Wim426F/HVCU-Hardware/(threads)

Thread 6 (2024-01-12):

fix CAN-bus IC part number. (must be 3.3v supply version)

Wim426F, 2024-01-12:

Wim426F, 2024-10-08:
Used SN65 for 3.3V and TJA1050 for 5V

Closed 2024-10-08.

Thread 7 (2024-01-12):

change 12v output to mosfets instead of transistors

Wim426F, 2024-01-12:
saves a few parts

Wim426F, 2024-10-08:
Kept transistors because they are used elsewhere already.
Did check the schematic again and had to flip 2 resistors in a divider network to prevent
transistor base overvoltage.

Closed 2024-10-08.

Thread 10 (2024-08-16):

Add chargeport temp sensor input

Wim426F, 2024-08-16:

Wim426F, 2024-10-09:
Added 1 chargeport temperature sensor input.
Circuit copied from tested superman controller schematic.

Closed 2024-10-09.

Thread 11 (2024-08-16):

Merge 2 connectors

Wim426F, 2024-08-16:
Merge 2 connectors for vehicle and i3 LIM

Wim426F, 2024-10-09:
Merged vehicle and i3 lim connector into 1 10-pin connector for easier wiring.

Closed 2024-10-09.
