Wim426F/HVCU-Hardware/hv_controller.pdf

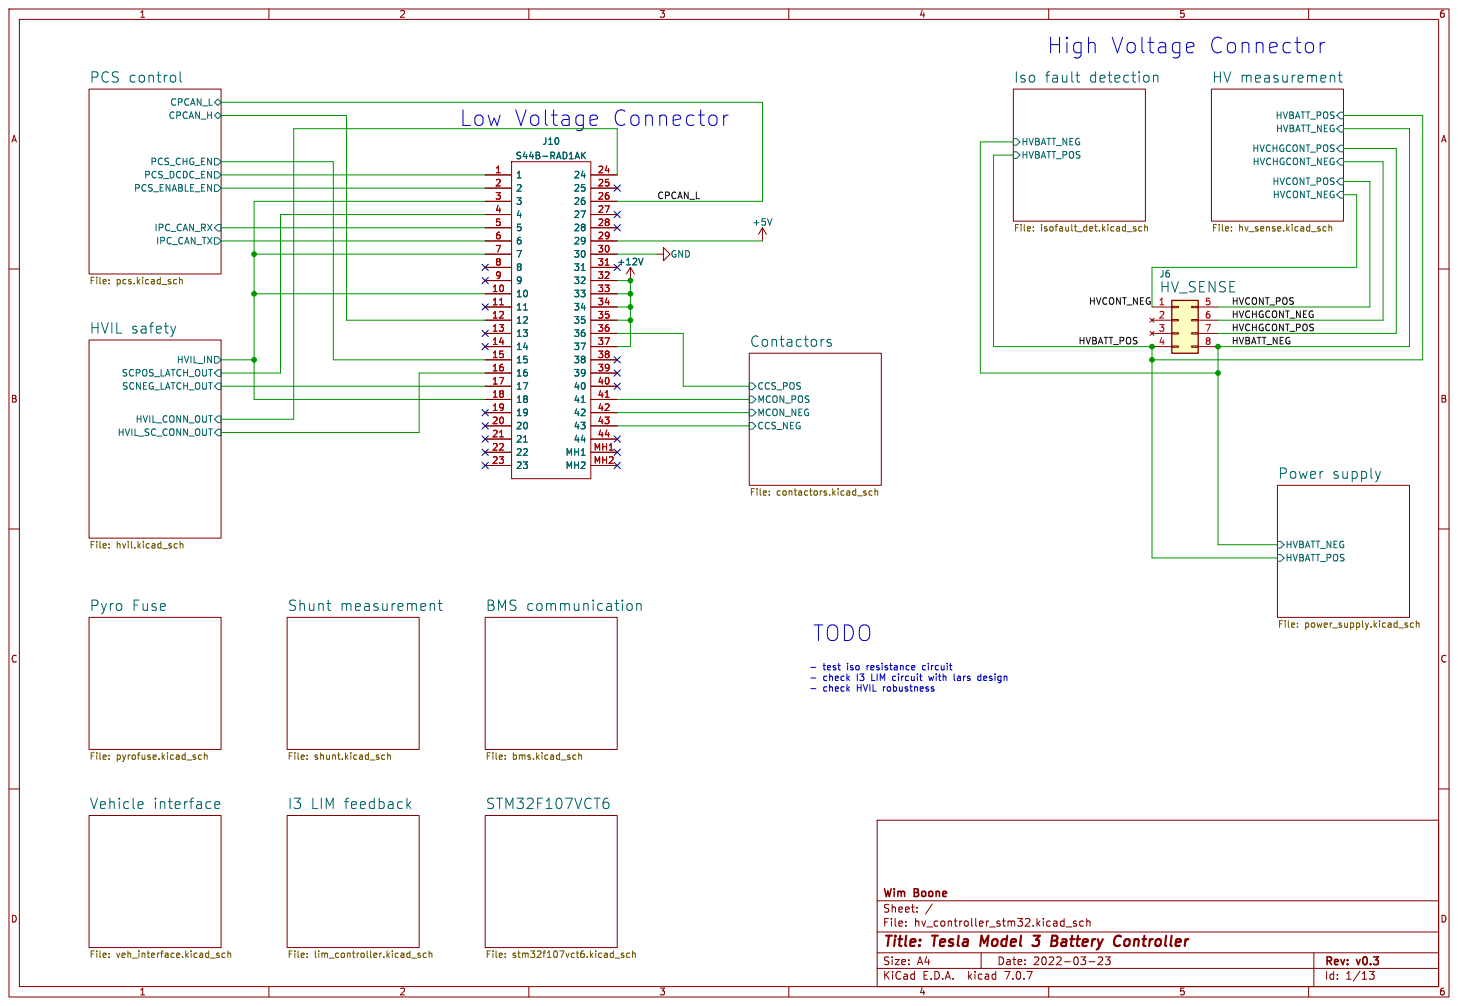
[picture p1: page 1]

HVCHGCONT_POS HV measurement File: hv_sense.kicad_sch Vehicle interface

File: contactors.kicad_sch BMS communication

File: hvil.kicad_sch Pyro Fuse

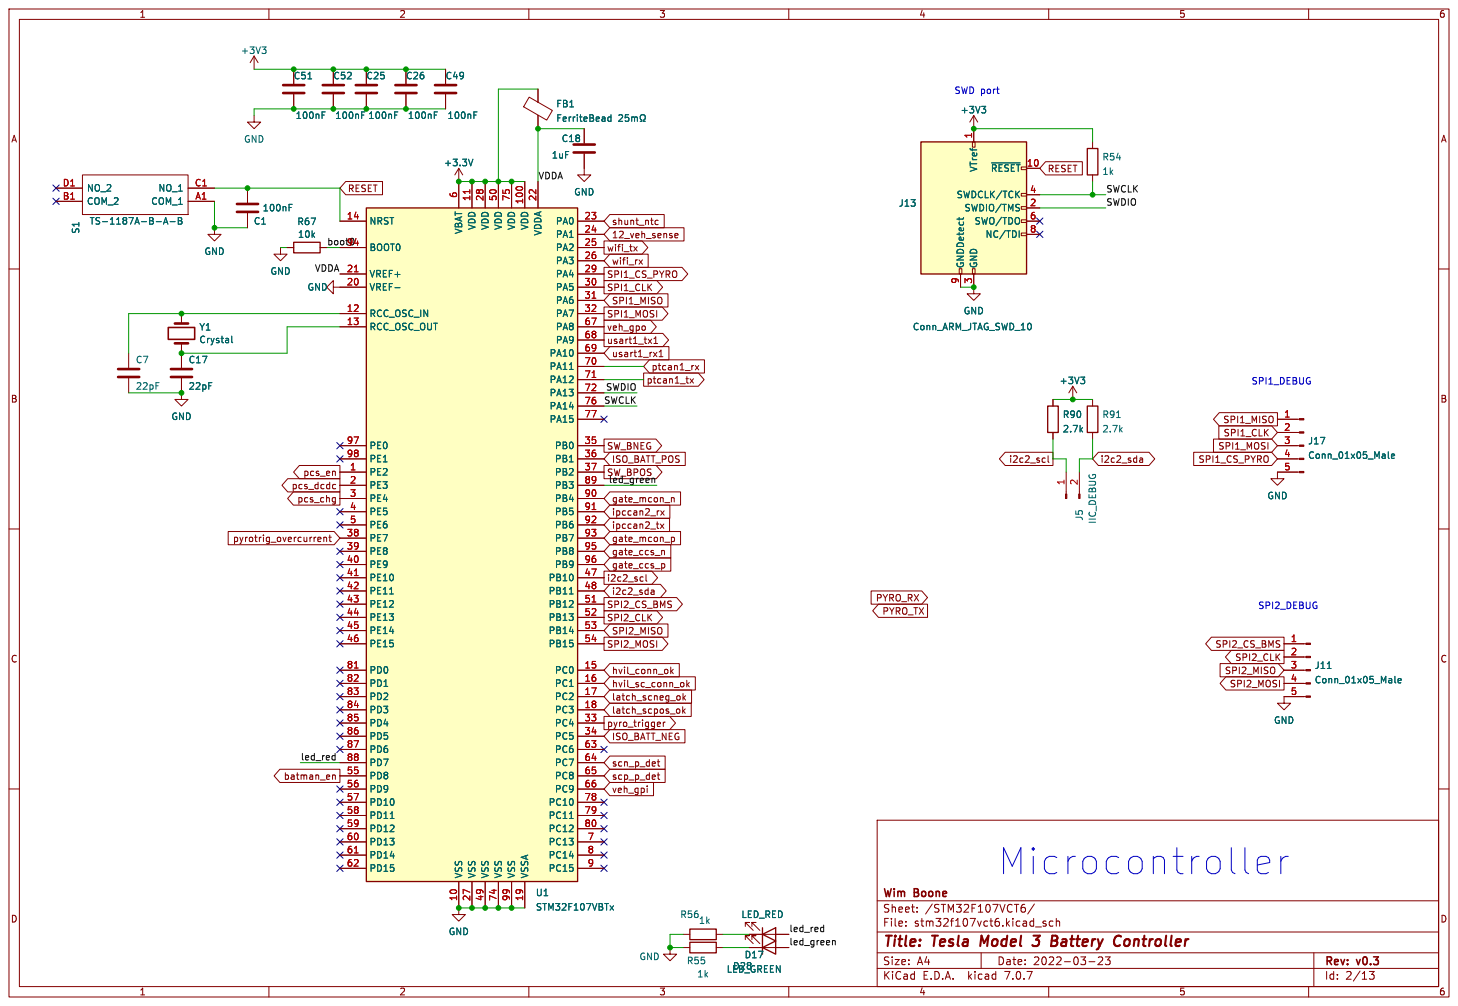
[picture p2: page 2]

3 SWDCLK/TCK 4 SWO/TDO 6 NC/TDI 8 GNDDetect 9

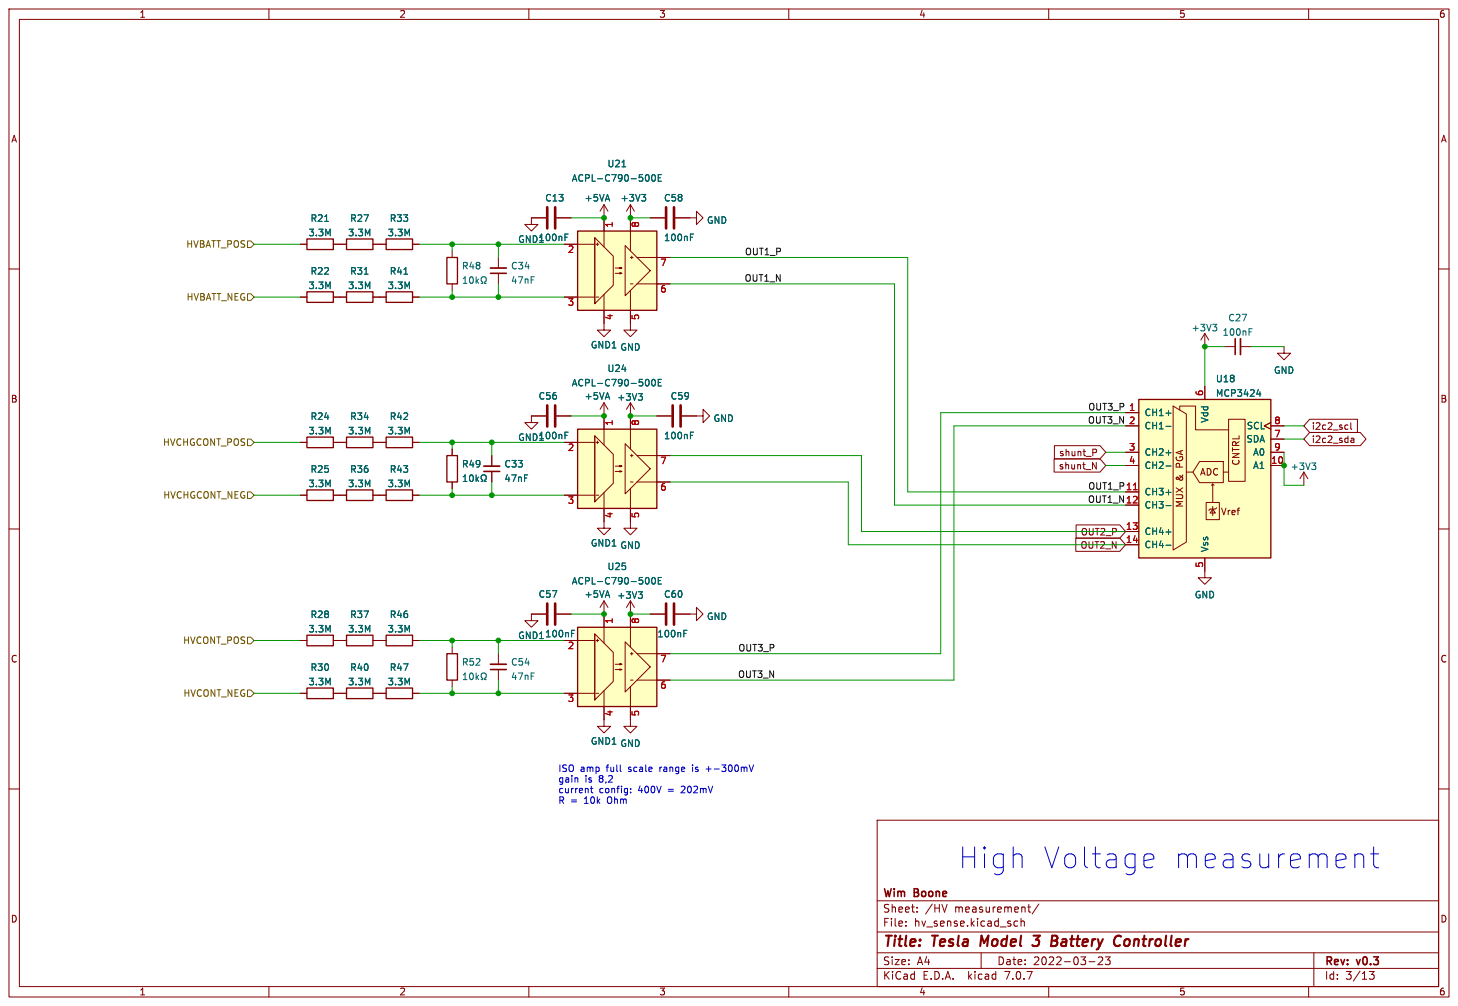
[picture p3: page 3]

ISO amp full scale range is +-300mV
gain is 8,2

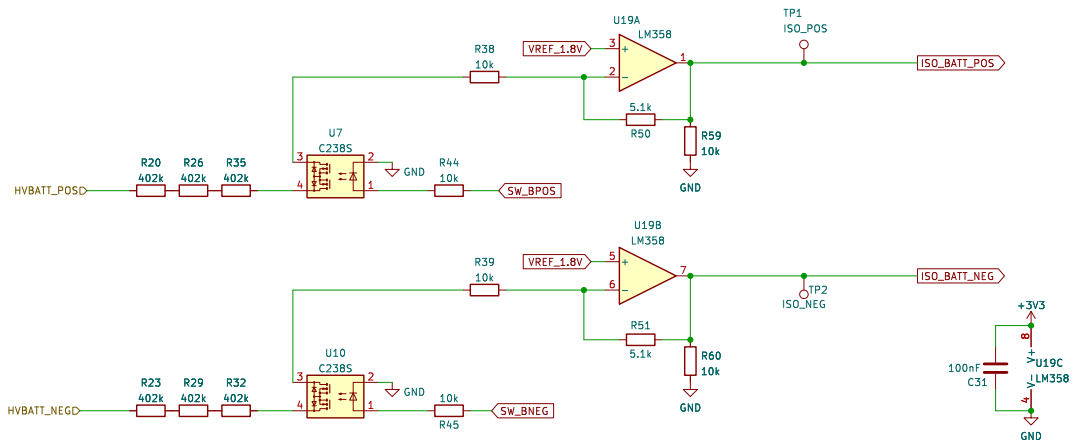
[picture p4: page 4]

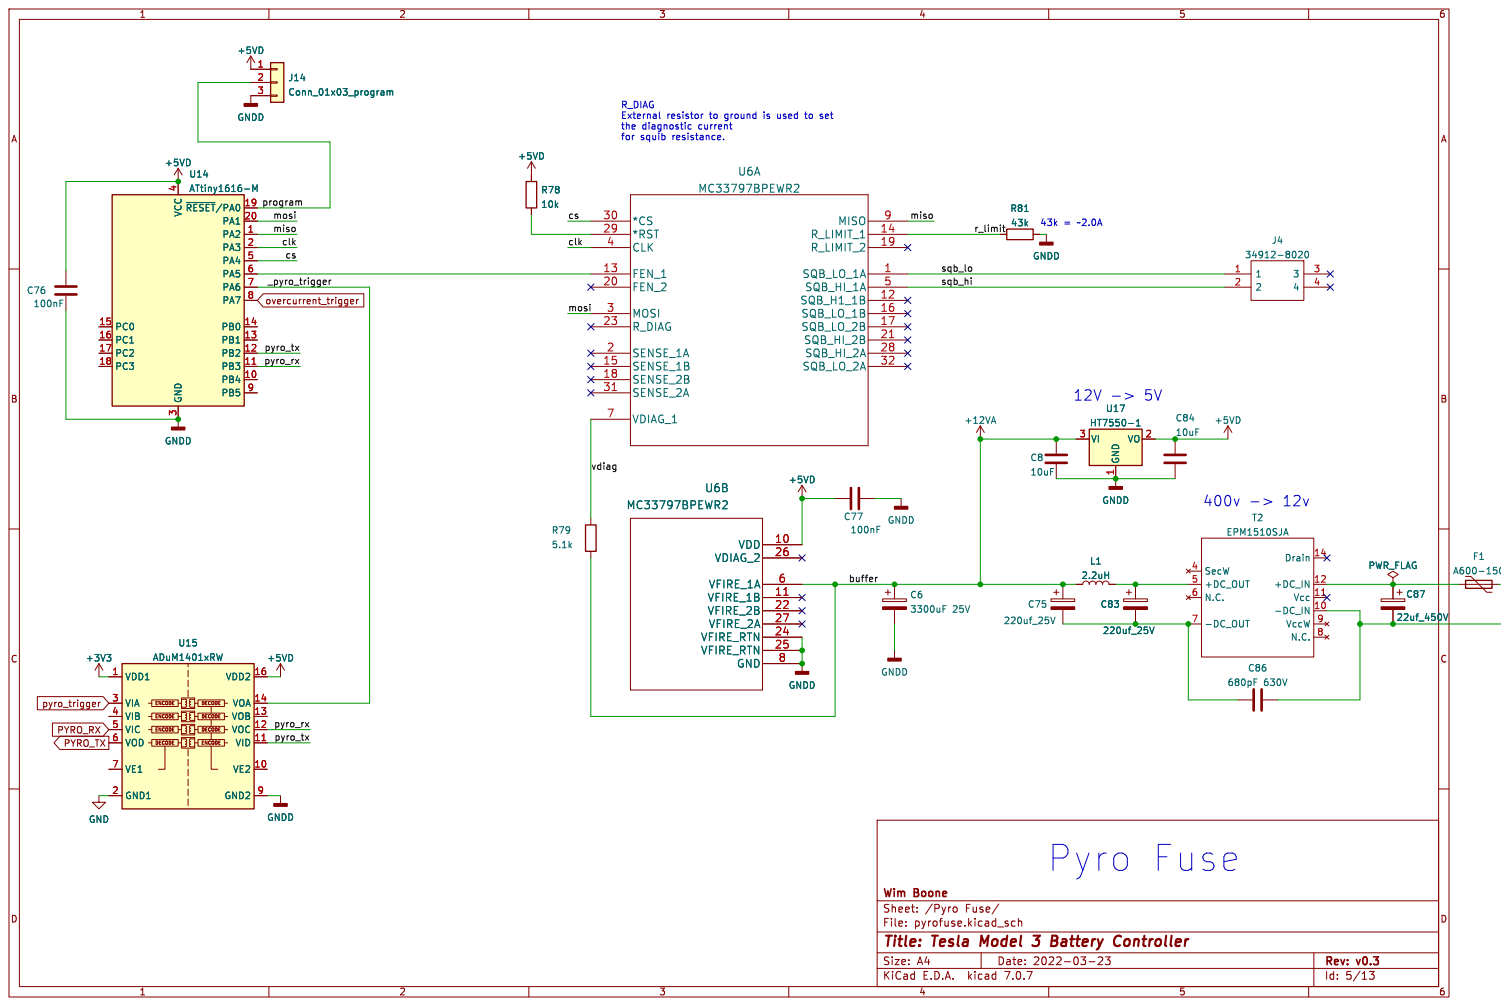
[picture p5: page 5]

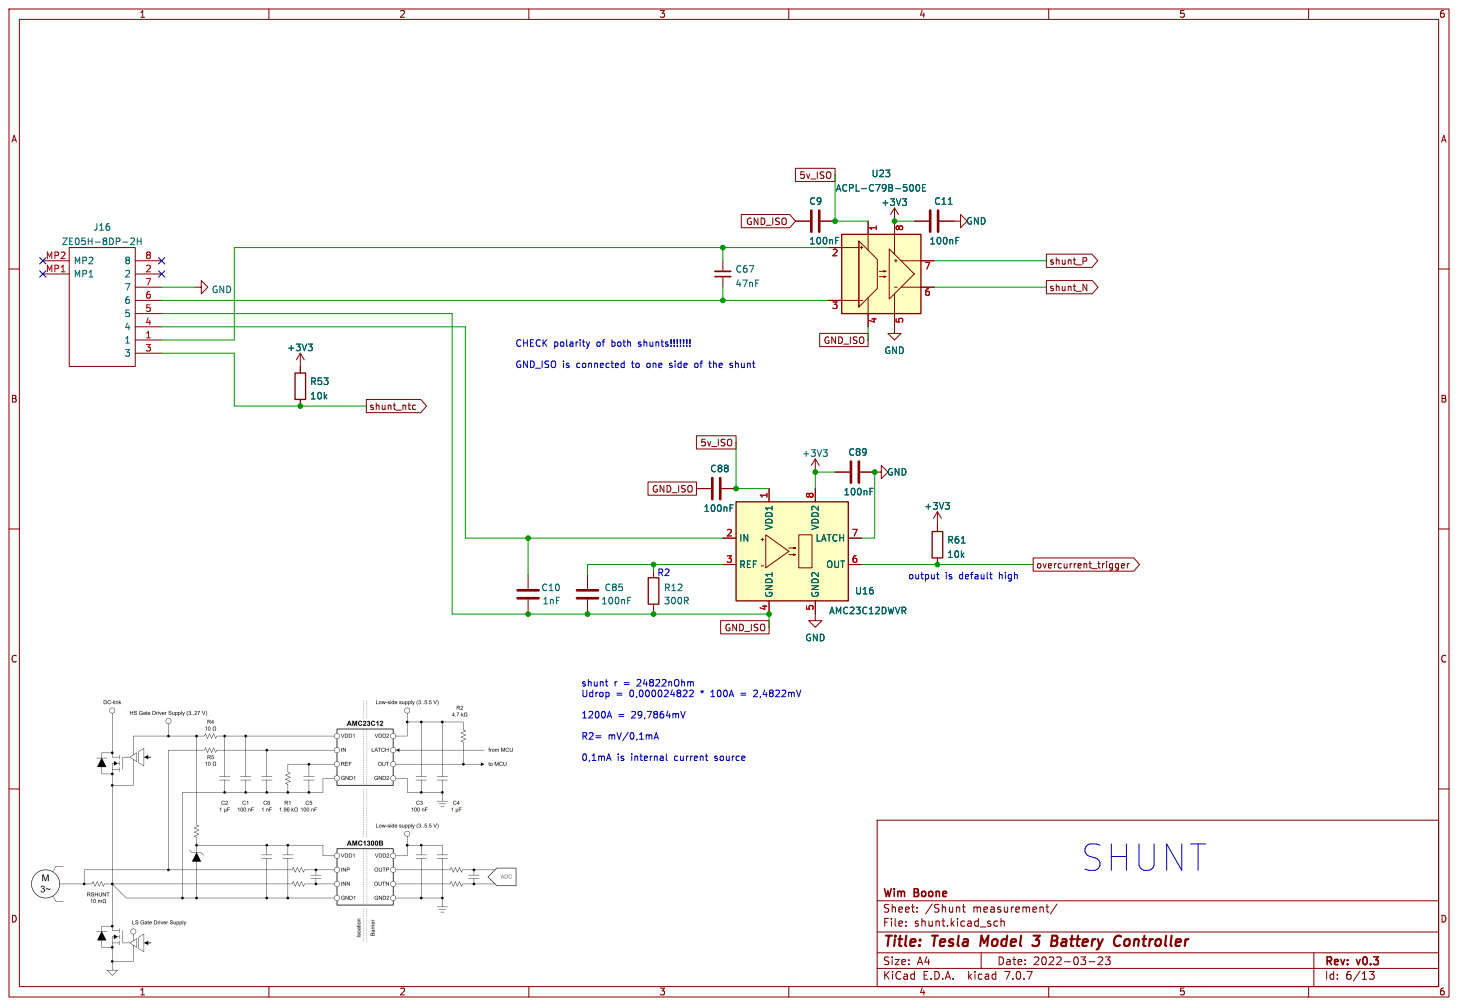
[picture p6: page 6]

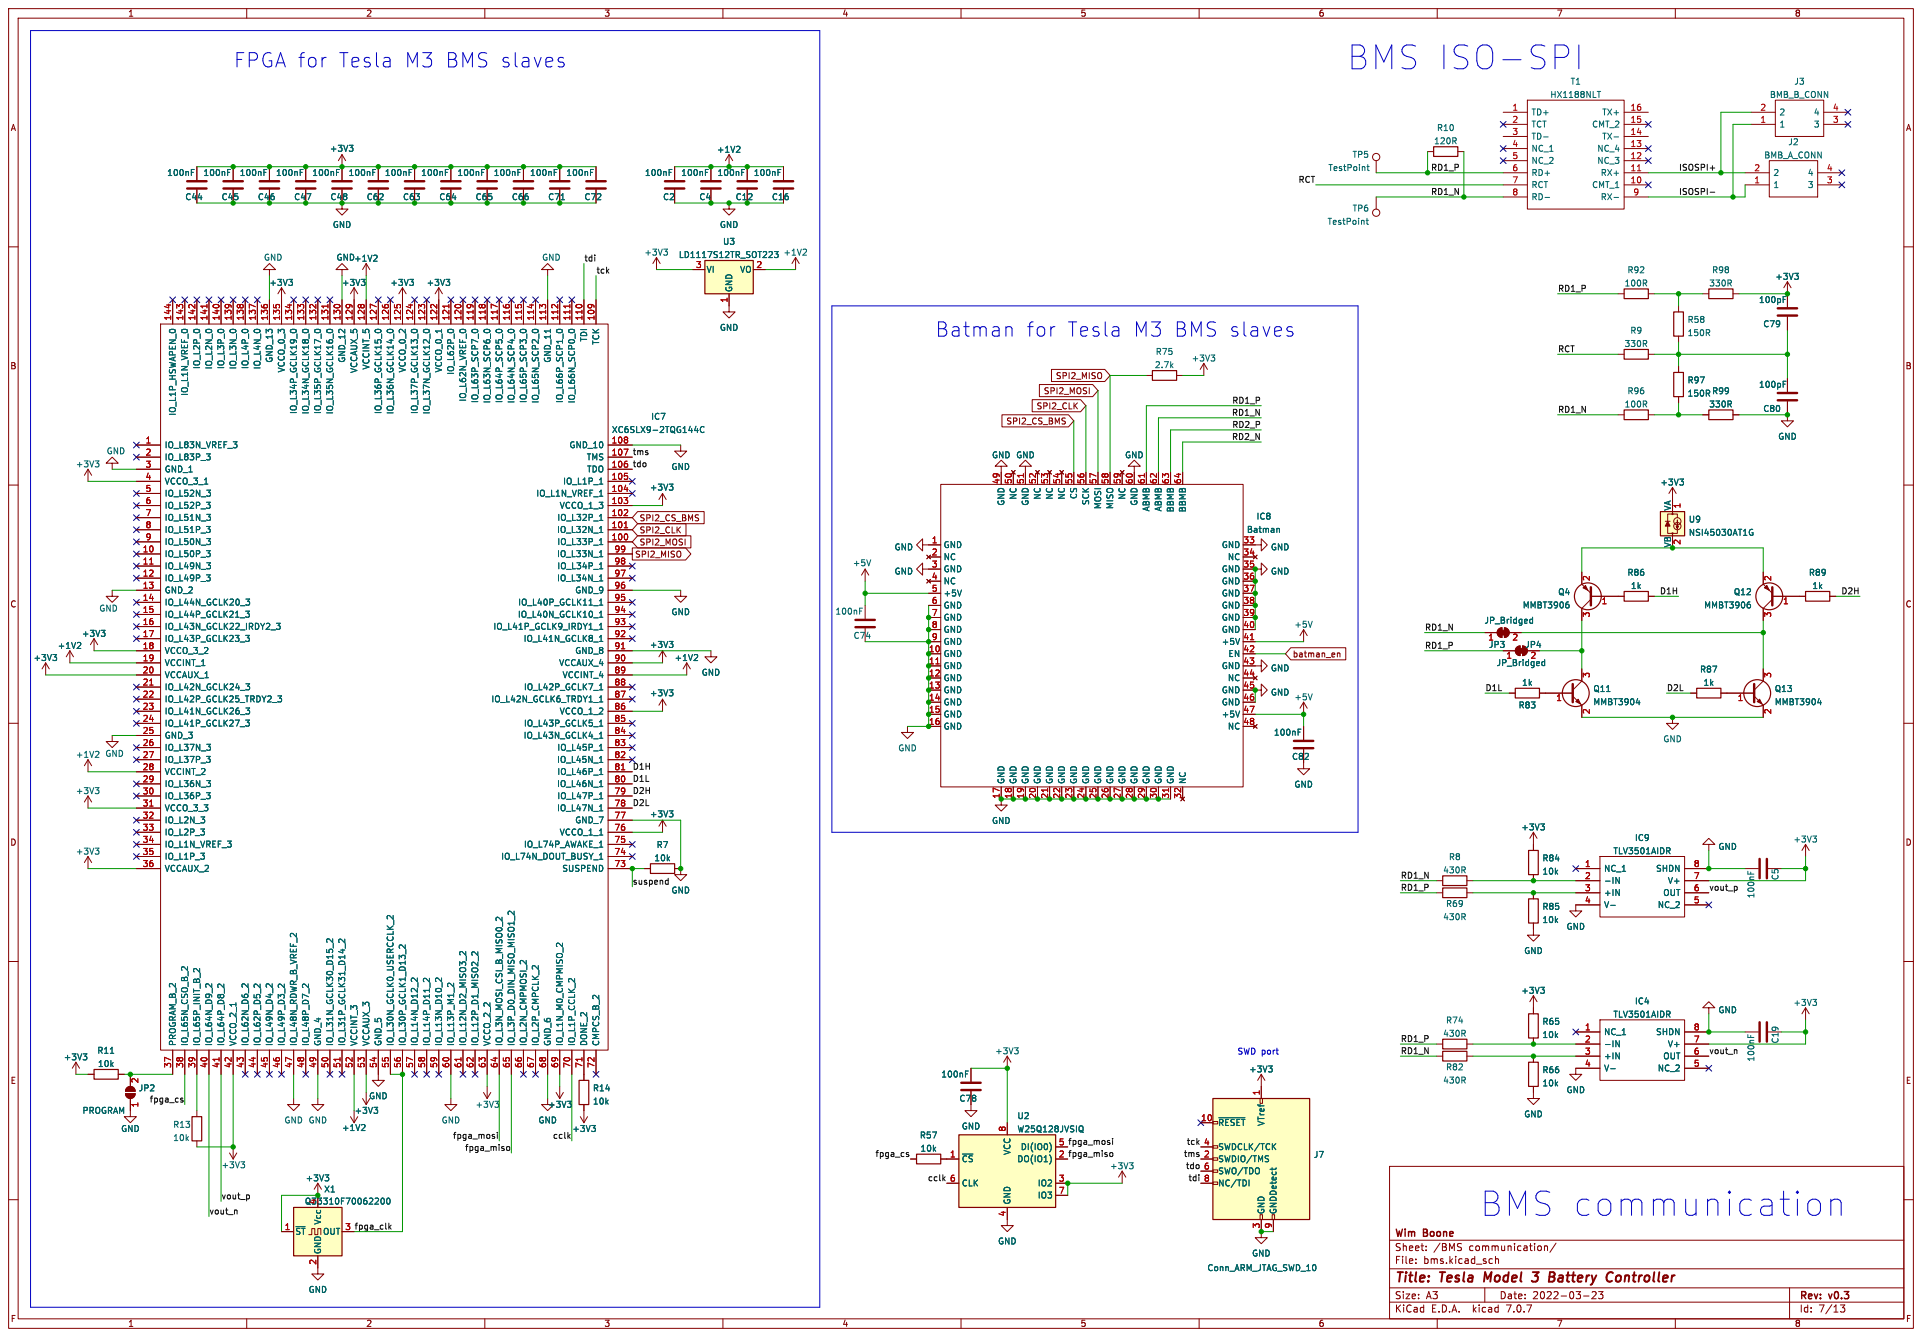
[picture p7: page 7]

Batman for Tesla M3 BMS slaves

8 GND GND GND GND

3 SWDCLK/TCK 4 SWO/TDO 6 NC/TDI 8 GNDDetect 9 +3V3 U2 W25Q128JVSIQ

2 OUT 3 Vcc 4 X1 Q33310F70062200 ~{CS} 1 DO(IO1) 2

3 SWDCLK/TCK 4 SWO/TDO 6 NC/TDI 8 GNDDetect 9

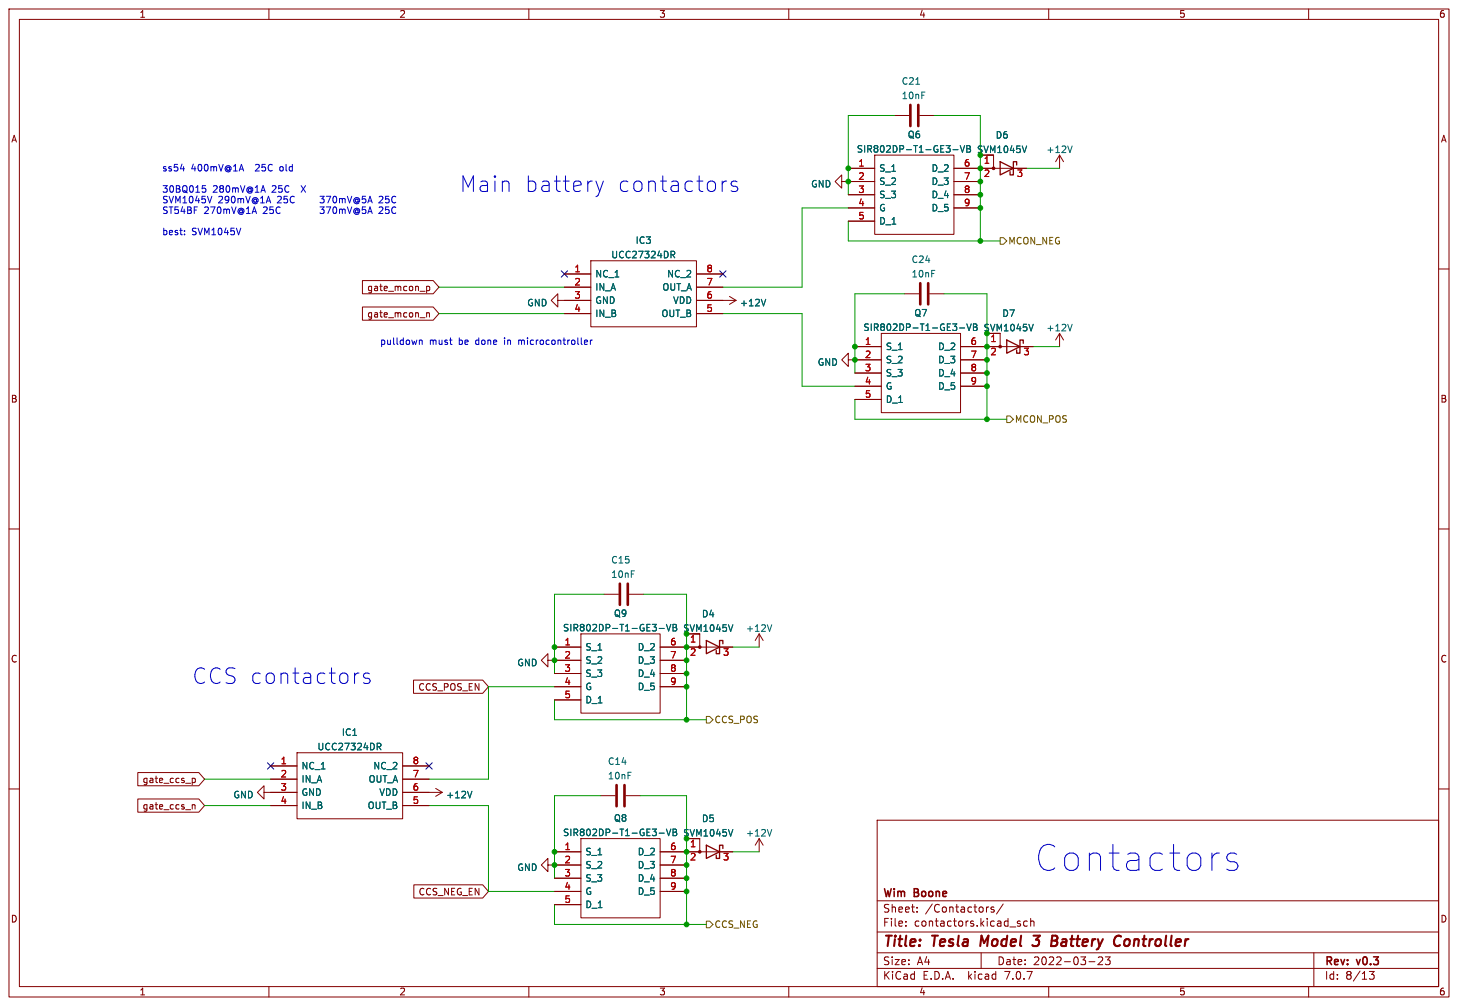
[picture p8: page 8]

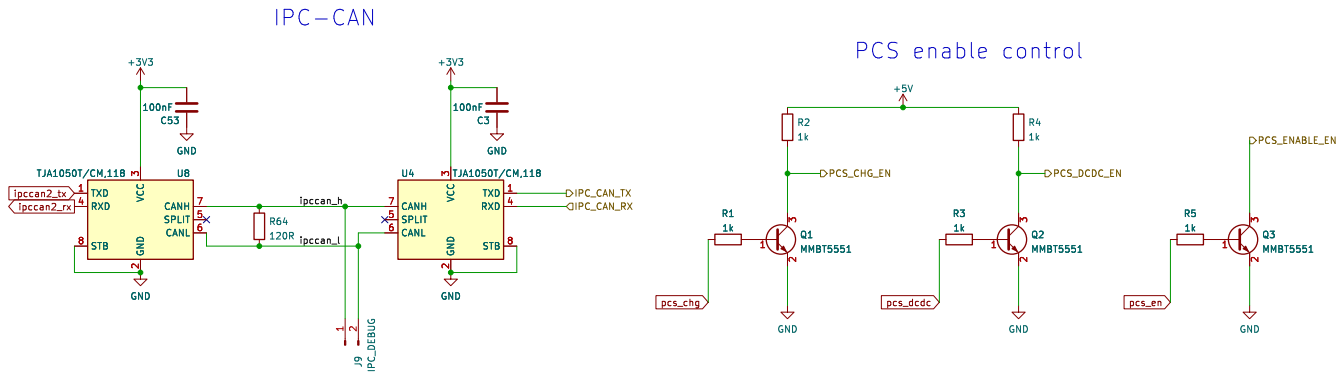
[picture p9: page 9]

3 RXD 4 SPLIT 5 CANL 6 CANH 7 STB 8 TJA1050T/CM,118 U8 GND

3 RXD 4 SPLIT 5 CANL 6 CANH 7 STB 8 GND

3 RXD 4 SPLIT 5 CANL 6 CANH 7 STB 8 U4 TJA1050T/CM,118 GND

3 RXD 4 SPLIT 5 CANL 6 CANH 7 STB 8

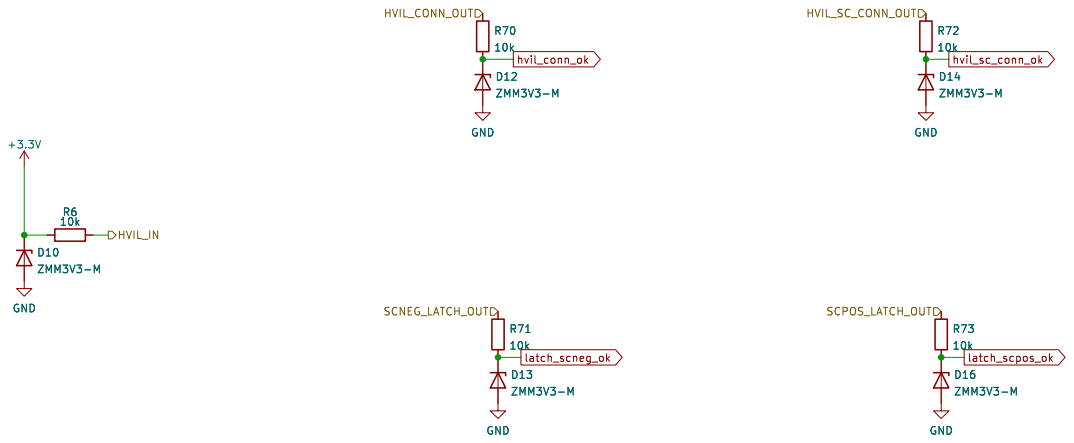
[picture p10: page 10]

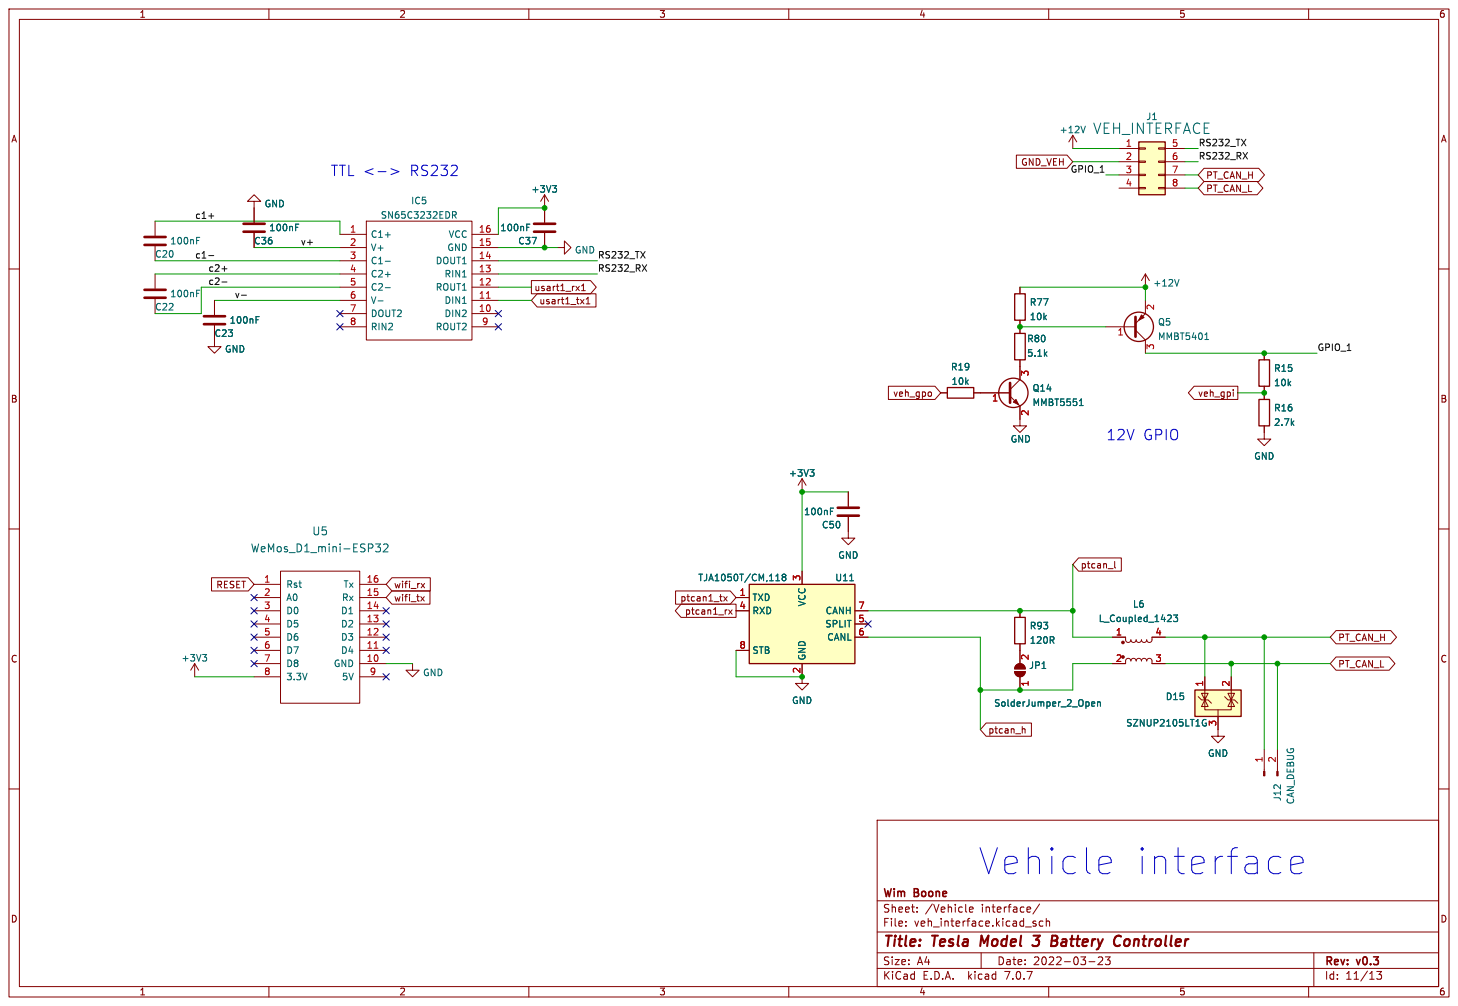
[picture p11: page 11]

3 RXD 4 SPLIT 5 CANL 6 CANH 7 STB 8 TJA1050T/CM,118 U11 R19

3 RXD 4 SPLIT 5 CANL 6 CANH 7 STB 8 GND

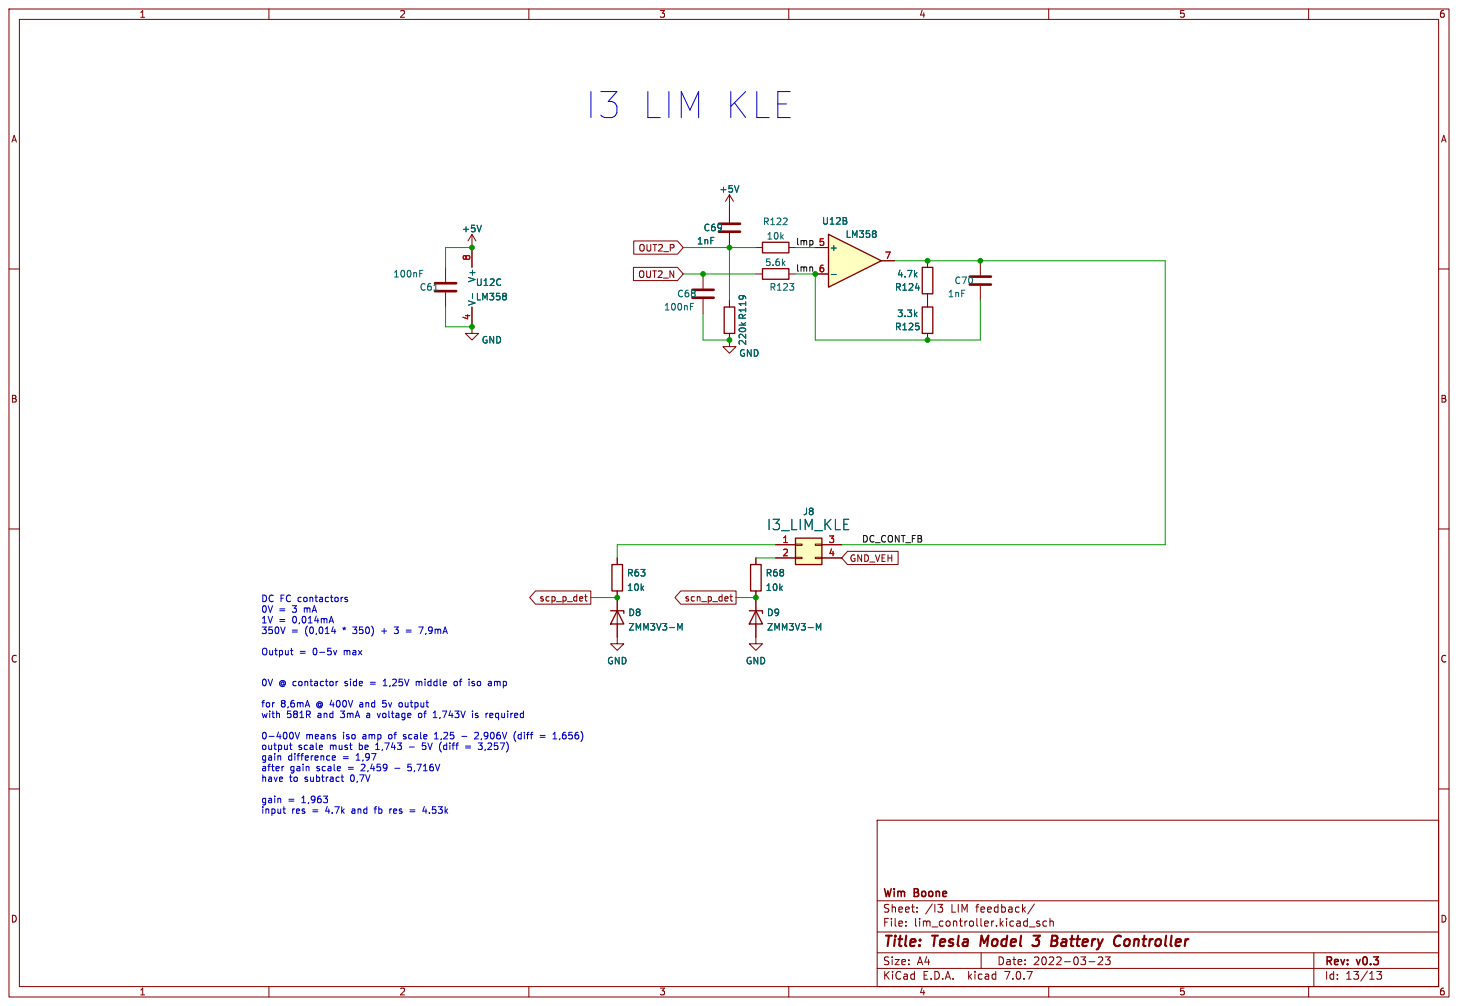
[picture p12: page 12]

input res = 4.7k and fb res = 4.53k DC FC contactors 0V = 3 mA

for 8,6mA @ 400V and 5v output with 581R and 3mA a voltage of 1,743V is required

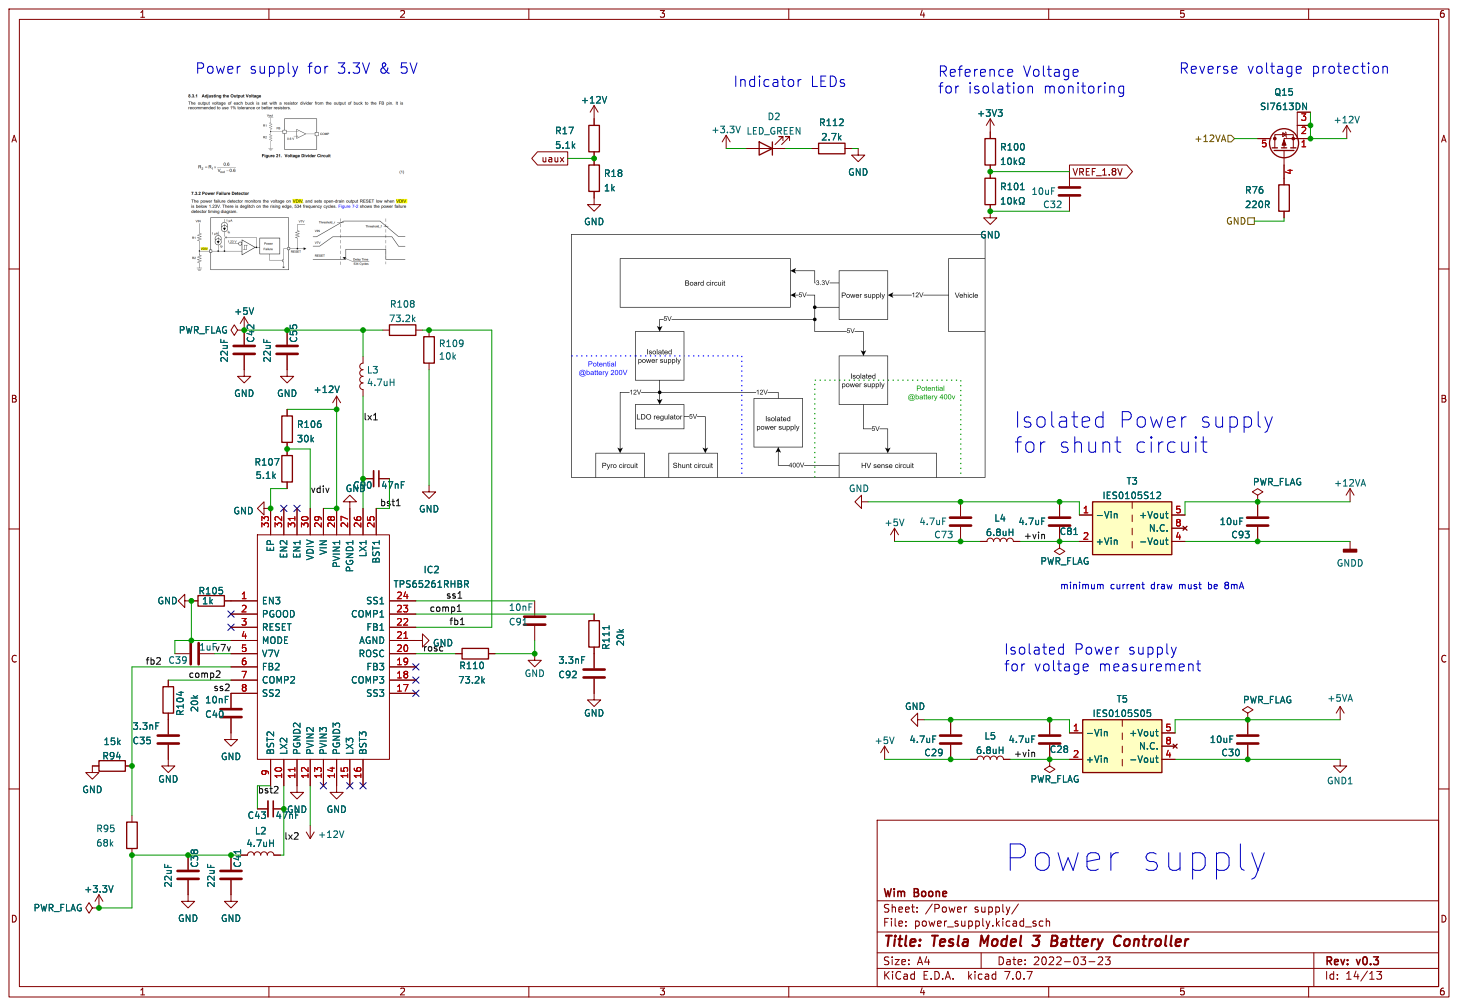
[picture p13: page 13]
