Wim426F/HVCU-Hardware/hv_controller.kicad_pcb

## KiCad design hv_controller.kicad_pcb (2024-01-13)

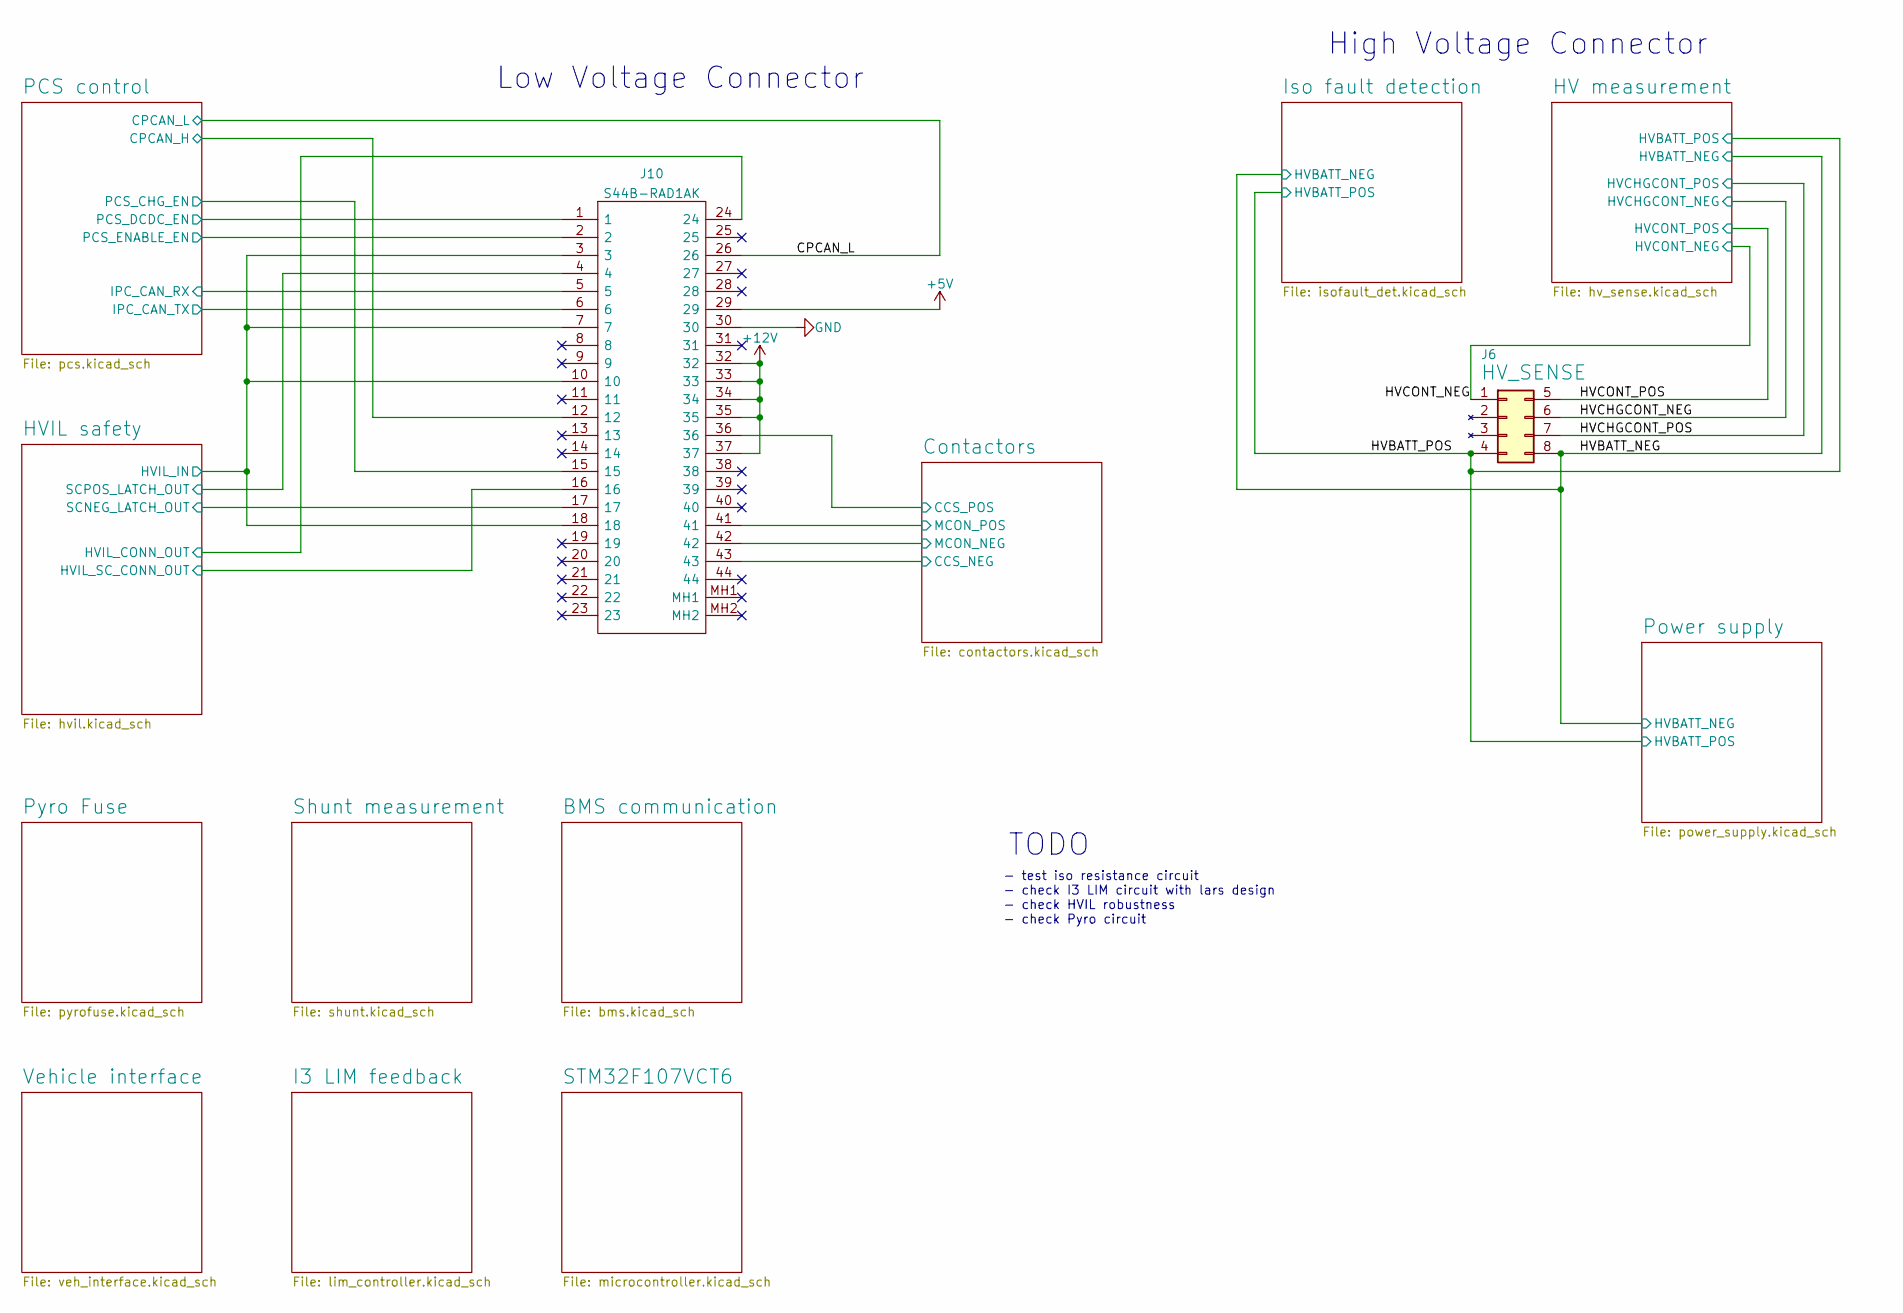
[picture p14: schematic hv_controller.kicad_sch, Tesla Model 3 Battery Controller]

Parts:
J6: HV_SENSE; Molex_Mini-Fit_Jr_5569-08A2_2x04_P4.20mm_Horizontal
J10: S44B-RAD1AK; S44BRAD1AK; Manufacturer_Part_Number S44B-RAD1AK; Mouser Part Number 306-S44B-RAD1AK

Connections:
+5V: J10.29; also elsewhere on the board
+12V: J10.32, J10.33, J10.34, J10.35, J10.37; also elsewhere on the board
/CPCAN_H: J10.12
/CPCAN_L: J10.26
/Contactors/CCS_NEG: J10.43; also elsewhere on the board
/Contactors/CCS_POS: J10.36; also elsewhere on the board
/Contactors/MCON_NEG: J10.42; also elsewhere on the board
/Contactors/MCON_POS: J10.41; also elsewhere on the board
/HVBATT_NEG: J6.8; also elsewhere on the board
/HVBATT_POS: J6.4; also elsewhere on the board
/HVCHGCONT_NEG: J6.6; also elsewhere on the board
/HVCHGCONT_POS: J6.7; also elsewhere on the board
/HVCONT_NEG: J6.1; also elsewhere on the board
/HVCONT_POS: J6.5; also elsewhere on the board
/HVIL safety/HVIL_CONN_OUT: J10.24; also elsewhere on the board
/HVIL safety/HVIL_IN: J10.3, J10.7, J10.10, J10.18; also elsewhere on the board
/HVIL safety/HVIL_SC_CONN_OUT: J10.16; also elsewhere on the board
/HVIL safety/SCNEG_LATCH_OUT: J10.17; also elsewhere on the board
/HVIL safety/SCPOS_LATCH_OUT: J10.4; also elsewhere on the board
/PCS control/IPC_CAN_RX: J10.5; also elsewhere on the board
/PCS control/IPC_CAN_TX: J10.6; also elsewhere on the board
/PCS control/PCS_CHG_EN: J10.15; also elsewhere on the board
/PCS control/PCS_DCDC_EN: J10.1; also elsewhere on the board
/PCS control/PCS_ENABLE_EN: J10.2; also elsewhere on the board
GND: J10.30; also elsewhere on the board

Notes on the sheet:
TODO
High Voltage Connector
Low Voltage Connector
- test iso resistance circuit - check I3 LIM circuit with lars design - check HVIL robustness - check Pyro circuit

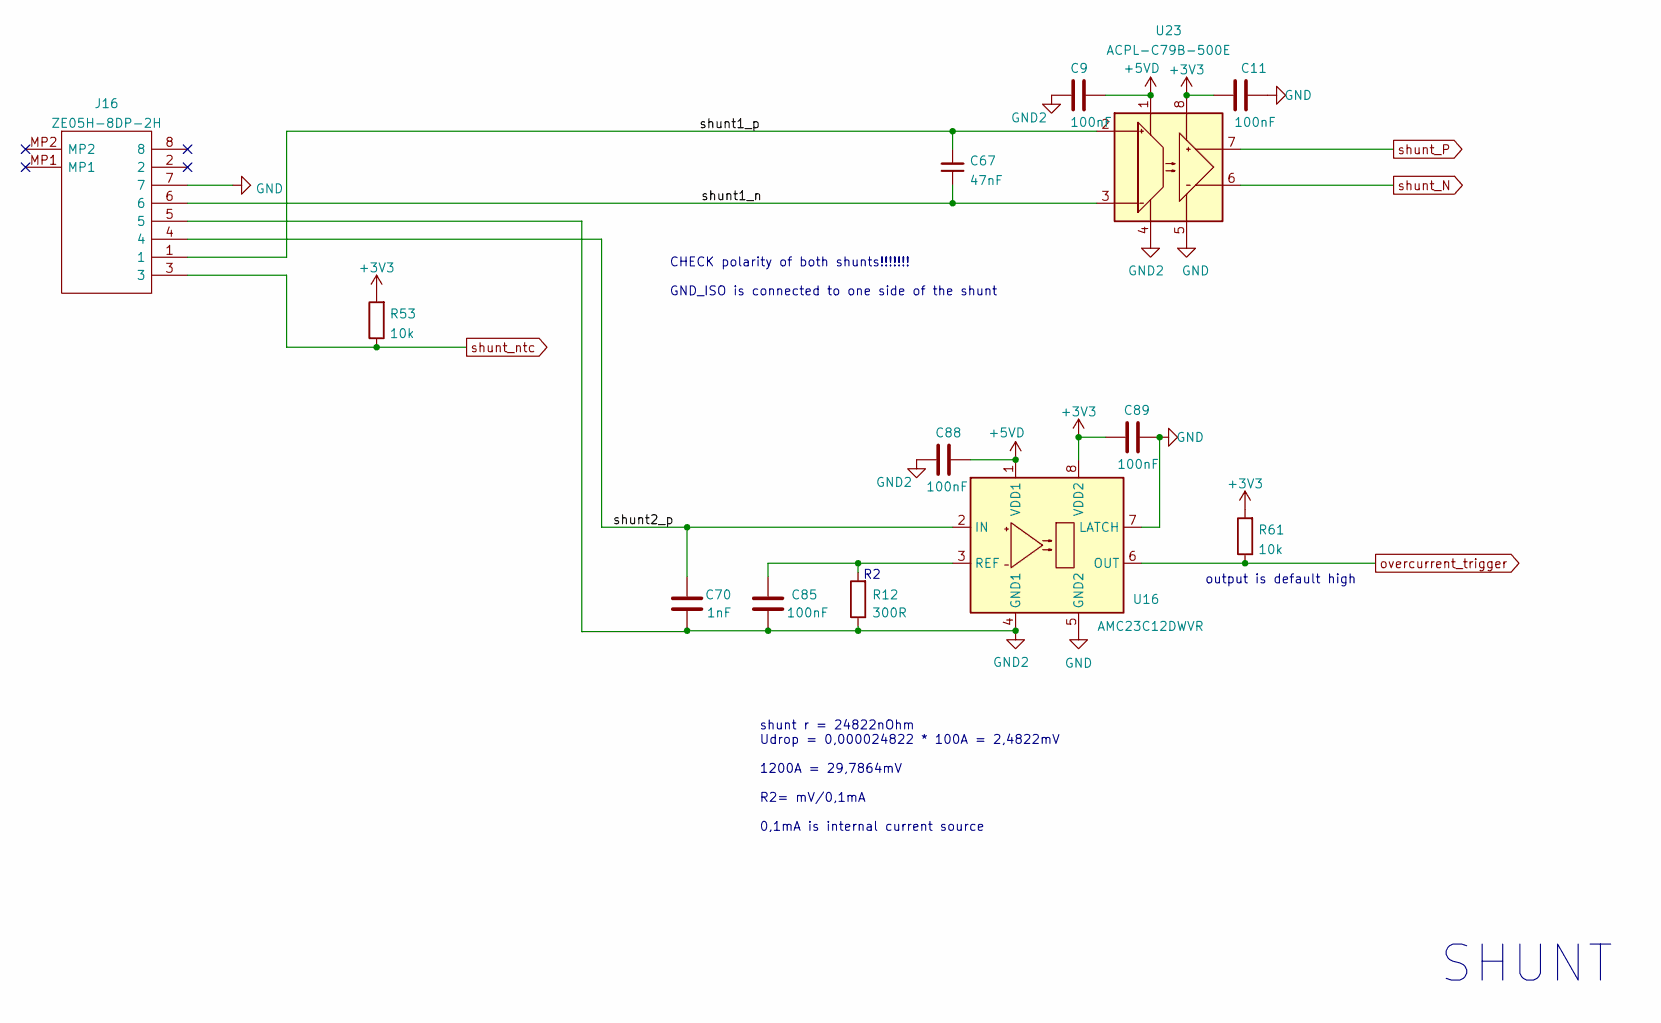
[picture p15: schematic shunt.kicad_sch, Tesla Model 3 Battery Controller]

Parts:
C9, C11, C85, C88, C89: 100nF; C_0603_1608Metric; LCSC Part C14663
C67: 47nF; C_0603_1608Metric; LCSC Part C1622
C70: 1nF; C_0603_1608Metric; LCSC Part C1588
J16: ZE05H-8DP-2H; ZE05H8DP2H; Manufacturer_Part_Number ZE05H-8DP-2H; Mouser Part Number 798-ZE05H-8DP-2H
R12: 300R; R_0603_1608Metric; LCSC Part C23025
R53, R61: 10k; R_0603_1608Metric; LCSC Part C25804
U16: AMC23C12DWVR; SOIC-8_7.5x5.85mm_P1.27mm; Mouser Part Number 595-AMC23C12DWVR
U23: ACPL-C79B-500E; SSO-8_6.8x5.9mm_P1.27mm_Clearance8mm; Mouser Part Number 595-AMC1300DWV; LCSC Part C691943

Connections:
+5VD: C9.1, C88.1, U16.1 (VDD1), U23.1 (VDD1); also elsewhere on the board
/Shunt measurement/shunt1_n: C67.1, J16.6, U23.3 (IN-)
/Shunt measurement/shunt1_p: C67.2, J16.1, U23.2 (IN+)
GND: C11.2, C89.2, J16.7, U16.5 (GND2), U16.7 (LATCH), U23.5 (GND2); also elsewhere on the board
unnamed: C85.2, R12.2, U16.3 (REF)
overcurrent_trigger: R61.1, U16.6 (OUT); also elsewhere on the board
shunt_N: U23.6 (OUT-); also elsewhere on the board
shunt_P: U23.7 (OUT+); also elsewhere on the board
shunt_ntc: J16.3, R53.1; also elsewhere on the board

Notes on the sheet:
SHUNT
output is default high
shunt r = 24822nOhm Udrop = 0,000024822 * 100A = 2,4822mV 1200A = 29,7864mV R2= mV/0,1mA 0,1mA is internal current source
CHECK polarity of both shunts!!!!!!! GND_ISO is connected to one side of the shunt

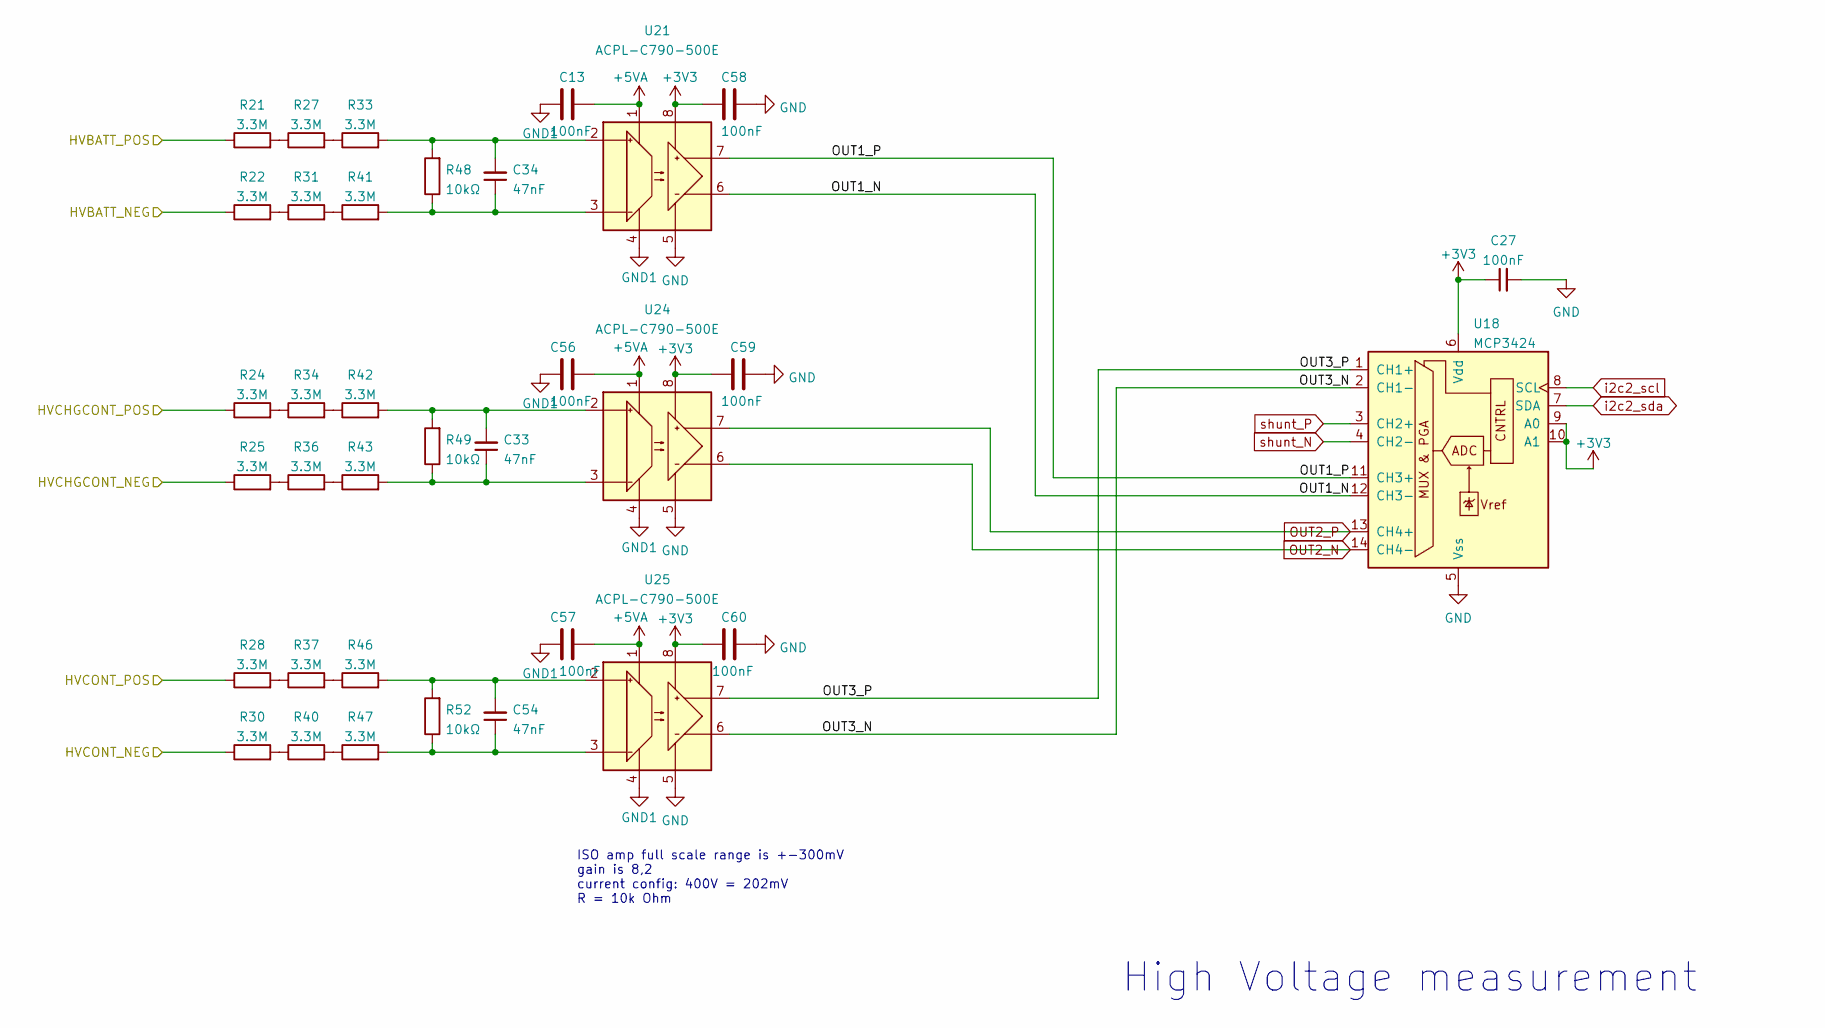
[picture p16: schematic hv_sense.kicad_sch, Tesla Model 3 Battery Controller]

Parts:
C13, C27, C56, C57, C58, C59, C60: 100nF; C_0603_1608Metric; LCSC Part C14663
C33, C34, C54: 47nF; C_0603_1608Metric; LCSC Part C1622
R21, R22, R24, R25, R27, R28, R30, R31, R33, R34, R36, R37, R40, R41, R42, R43, R46, R47: 3.3M; R_0805_2012Metric_Pad1.20x1.40mm_HandSolder; Manufacturer_Part_Number RG2012P-225-B-T5; Mouser Part Number 594-MCU0805MD3304BP5
R48, R49, R52: 10kΩ; R_0402_1005Metric_Pad0.72x0.64mm_HandSolder; LCSC Part C328417
U18: MCP3424; SOIC-14_3.9x8.7mm_P1.27mm; Mouser Part Number 579-MCP3424-E/SL; LCSC Part C640884
U21, U24, U25: ACPL-C790-500E; SSO-8_6.8x5.9mm_P1.27mm_Clearance8mm; Mouser Part Number 595-AMC1300DWV; LCSC Part C545687

Connections:
+5VA: C13.1, C56.1, C57.1, U21.1 (VDD1), U24.1 (VDD1), U25.1 (VDD1); also elsewhere on the board
/HV measurement/OUT1_N: U18.12 (CH3-), U21.6 (OUT-)
/HV measurement/OUT1_P: U18.11 (CH3+), U21.7 (OUT+)
/HV measurement/OUT3_N: U18.2 (CH1-), U25.6 (OUT-)
/HV measurement/OUT3_P: U18.1 (CH1+), U25.7 (OUT+)
/HVBATT_NEG: R22.1; also elsewhere on the board
/HVBATT_POS: R21.1; also elsewhere on the board
/HVCHGCONT_NEG: R25.1; also elsewhere on the board
/HVCHGCONT_POS: R24.1; also elsewhere on the board
/HVCONT_NEG: R30.1; also elsewhere on the board
/HVCONT_POS: R28.1; also elsewhere on the board
GND: C27.2, C58.1, C59.1, C60.1, U18.5 (Vss), U21.5 (GND2), U24.5 (GND2), U25.5 (GND2); also elsewhere on the board
GND1: C13.2, C56.2, C57.2, U21.4 (GND1), U24.4 (GND1), U25.4 (GND1); also elsewhere on the board
unnamed: R21.2, R27.1
unnamed: R22.2, R31.1
unnamed: R24.2, R34.1
unnamed: R25.2, R36.1
unnamed: R27.2, R33.1
unnamed: R28.2, R37.1
unnamed: R30.2, R40.1
unnamed: R31.2, R41.1
unnamed: R34.2, R42.1
unnamed: R36.2, R43.1
unnamed: R37.2, R46.1
unnamed: R40.2, R47.1
unnamed: C34.2, R33.2, R48.2, U21.2 (IN+)
unnamed: C34.1, R41.2, R48.1, U21.3 (IN-)
unnamed: C33.2, R42.2, R49.2, U24.2 (IN+)
unnamed: C33.1, R43.2, R49.1, U24.3 (IN-)
unnamed: C54.2, R46.2, R52.2, U25.2 (IN+)
unnamed: C54.1, R47.2, R52.1, U25.3 (IN-)
OUT2_N: U18.14 (CH4-), U24.6 (OUT-); also elsewhere on the board
OUT2_P: U18.13 (CH4+), U24.7 (OUT+); also elsewhere on the board
i2c2_scl: U18.8 (SCL); also elsewhere on the board
i2c2_sda: U18.7 (SDA); also elsewhere on the board
shunt_N: U18.4 (CH2-); also elsewhere on the board
shunt_P: U18.3 (CH2+); also elsewhere on the board

Notes on the sheet:
High Voltage measurement
ISO amp full scale range is +-300mV gain is 8,2 current config: 400V = 202mV R = 10k Ohm

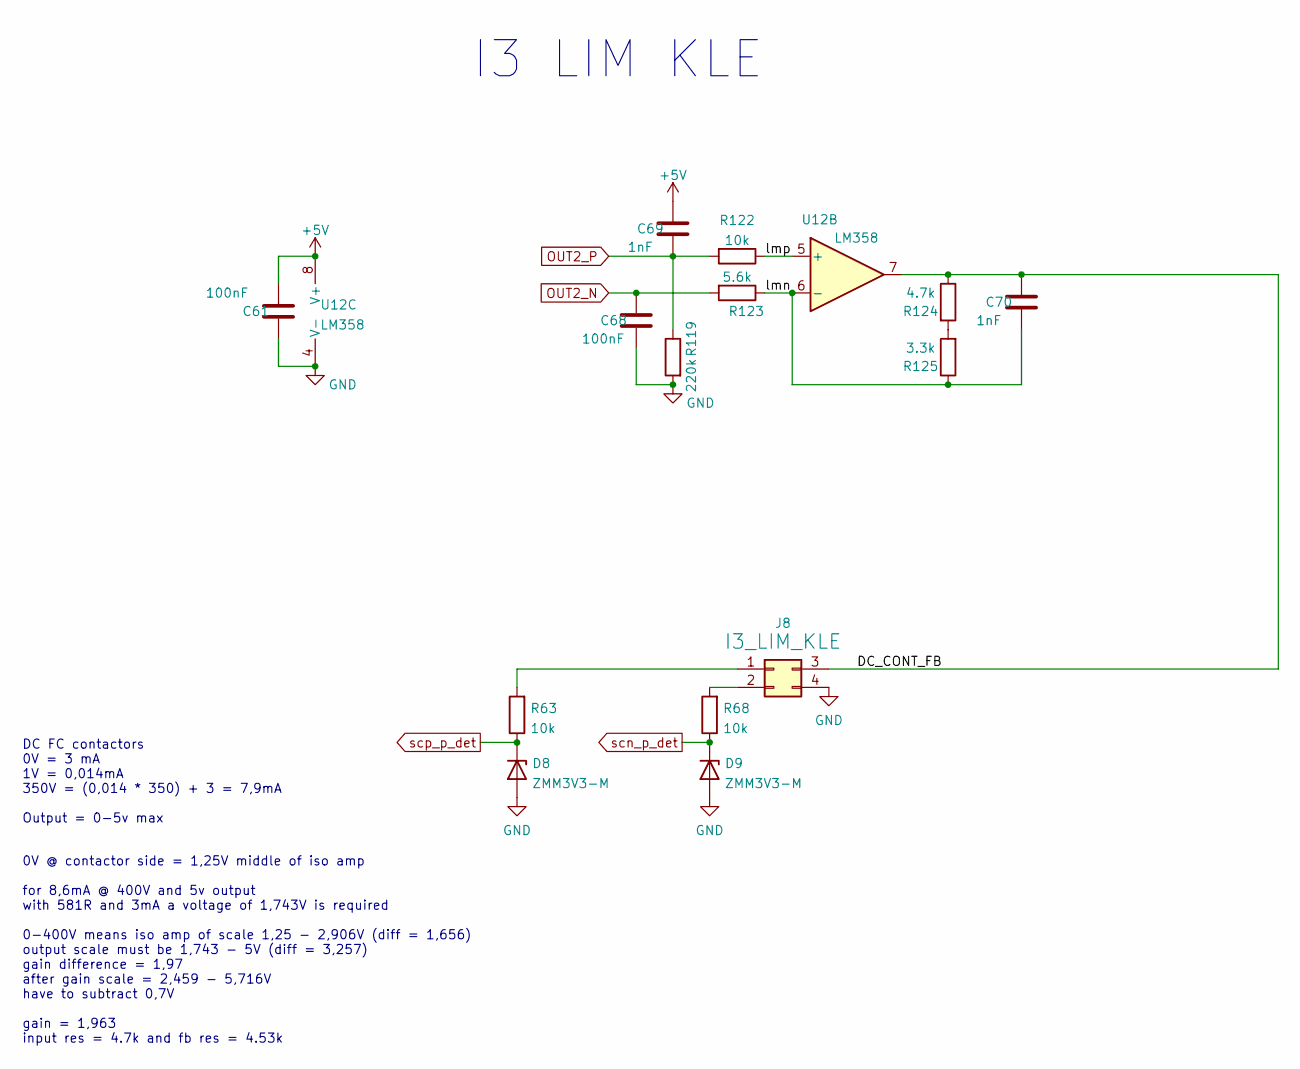
[picture p17: schematic lim_controller.kicad_sch, Tesla Model 3 Battery Controller]

Parts:
C61, C68: 100nF; C_0603_1608Metric; LCSC Part C14663
C69, C70: 1nF; C_0603_1608Metric; LCSC Part C1588
D8, D9: ZMM3V3-M; D_MiniMELF; LCSC Part C8056
J8: I3_LIM_KLE; Molex_MiniFit-JR-5569-04A2_2x02x4.20mm_Angled; Mouser Part Number 538-26-01-3115
R63, R68, R122: 10k; R_0603_1608Metric; LCSC Part C25804
R119: 220k; R_0603_1608Metric; LCSC Part C22961
R123: 5.6k; R_0603_1608Metric; LCSC Part C23189
R124: 4.7k; R_0603_1608Metric; LCSC Part C23162
R125: 3.3k; R_0603_1608Metric; LCSC Part C22978
U12: LM358; SOIC-8_3.9x4.9mm_P1.27mm; LCSC Part C7950

Connections:
+5V: C61.1, C69.1, U12.8 (V+); also elsewhere on the board
/I3 LIM feedback/lmp: R122.1, U12.5 (+)
GND: C61.2, C68.2, D8.2 (A), D9.2 (A), J8.4, R119.2, U12.4 (V-); also elsewhere on the board
unnamed: J8.1, R63.2
unnamed: J8.2, R68.2
unnamed: R124.2, R125.2
OUT2_N: C68.1, R123.2; also elsewhere on the board
OUT2_P: C69.2, R119.1, R122.2; also elsewhere on the board
scn_p_det: D9.1 (K), R68.1; also elsewhere on the board
scp_p_det: D8.1 (K), R63.1; also elsewhere on the board

Notes on the sheet:
0V @ contactor side = 1,25V middle of iso amp for 8,6mA @ 400V and 5v output with 581R and 3mA a voltage of 1,743V is required 0-400V means iso amp of scale 1,25 - 2,906V (diff = 1,656) output scale must be 1,743 - 5V (diff = 3,257) gain difference = 1,97 after gain scale = 2,459 - 5,716V have to s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
DC FC contactors 0V = 3 mA 1V = 0,014mA 350V = (0,014 * 350) + 3 = 7,9mA Output = 0-5v max
I3 LIM KLE

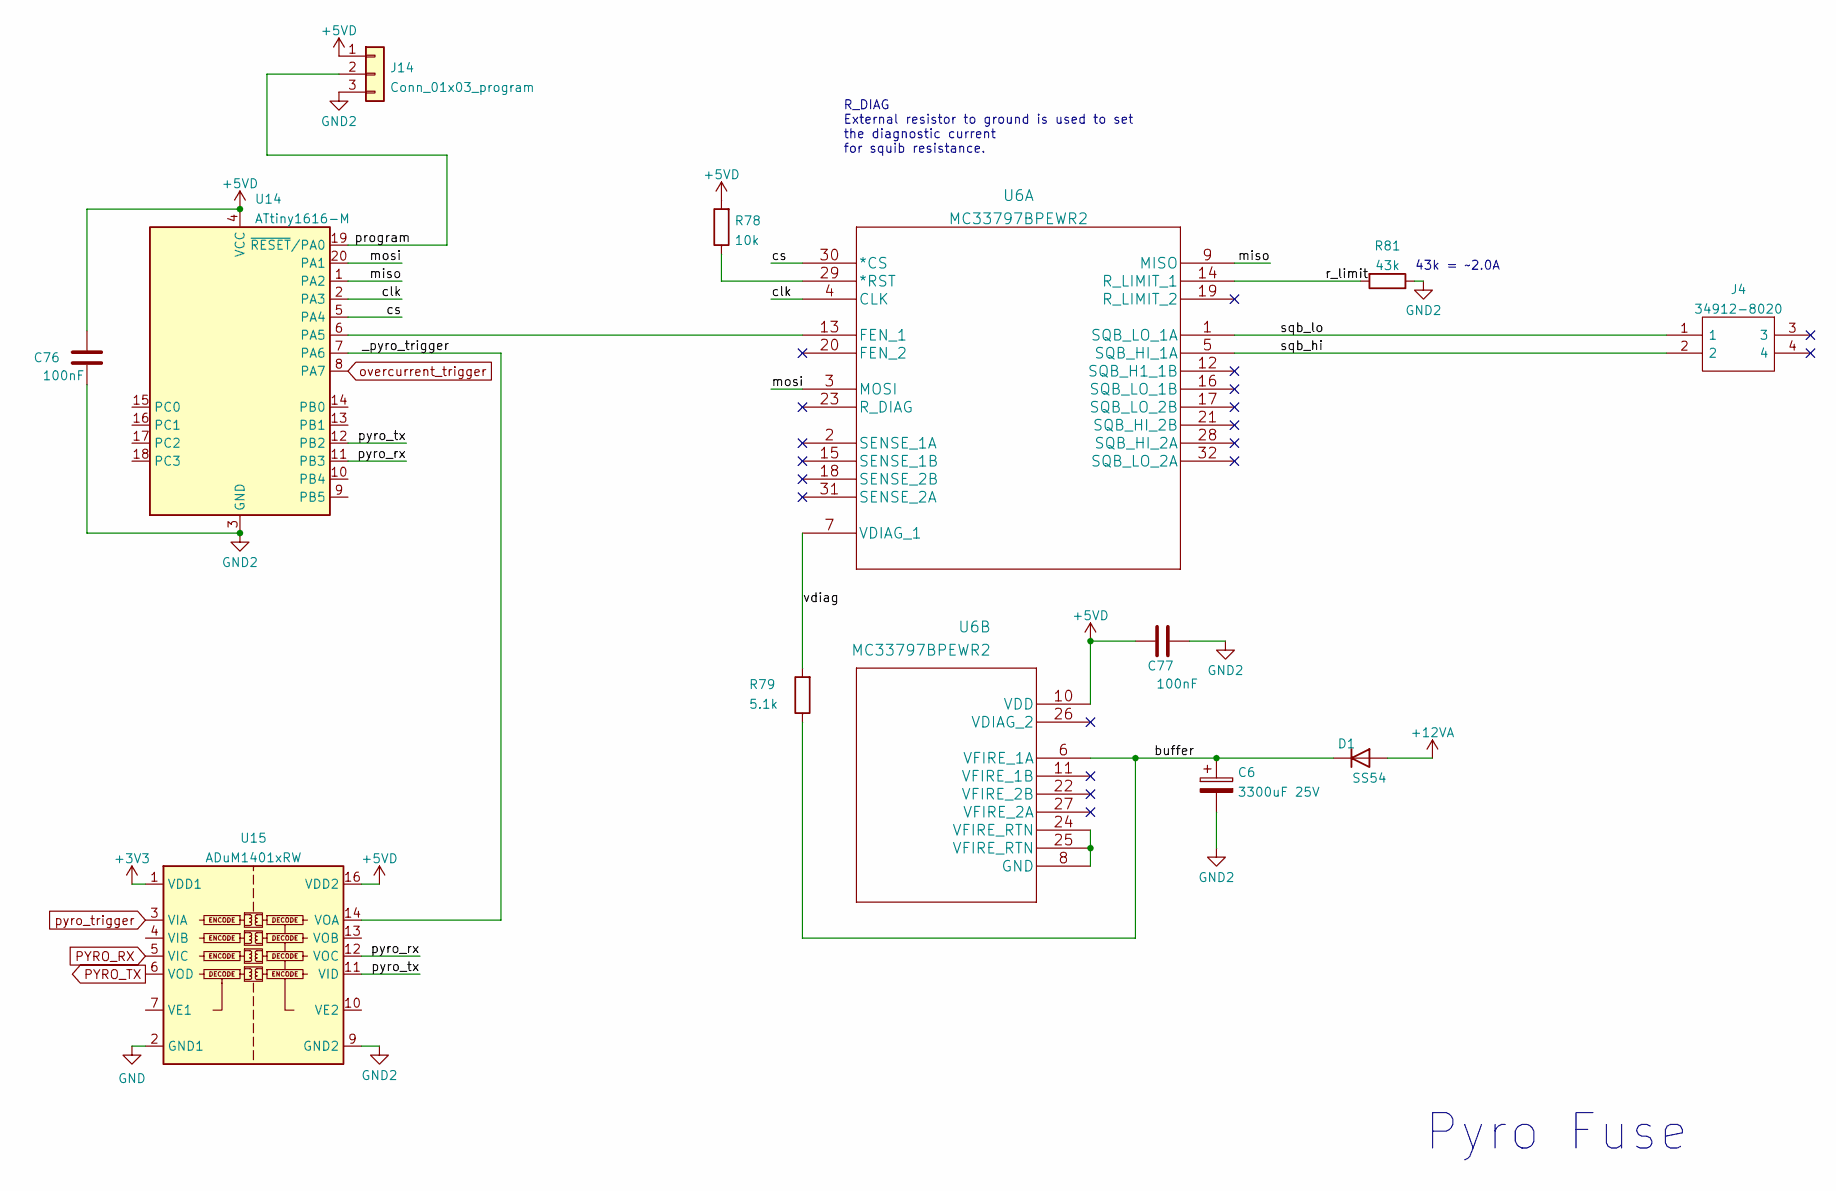
[picture p18: schematic pyrofuse.kicad_sch, Tesla Model 3 Battery Controller]

Parts:
C6: 3300uF 25V; CP_Radial_D16.0mm_P7.50mm; LCSC Part C442846
C76, C77: 100nF; C_0603_1608Metric; LCSC Part C14663
D1: SS54; D_SMA; LCSC Part C22452
J4: 34912-8020; 0349128020; Manufacturer_Part_Number 34912-8020; Mouser Part Number 538-34912-8022
J14: Conn_01x03_program; PinHeader_1x03_P2.54mm_Vertical
R78: 10k; R_0603_1608Metric; LCSC Part C25804
R79: 5.1k; R_0603_1608Metric; LCSC Part C23186
R81: 43k; R_0603_1608Metric; LCSC Part C445638
U6: MC33797BPEWR2; Manufacturer_Part_Number MC33797BPEWR2; LCSC Part C729196
U14: ATtiny1616-M; VQFN-20-1EP_3x3mm_P0.4mm_EP1.7x1.7mm; LCSC Part C507118
U15: ADuM1401xRW; SOIC-16W_7.5x10.3mm_P1.27mm; LCSC Part C33273

Connections:
+5VD: C76.1, C77.2, J14.1, R78.2, U6.10 (VDD), U14.4 (VCC), U15.16 (VDD2); also elsewhere on the board
+12VA: D1.2 (A); also elsewhere on the board
/Pyro Fuse/_pyro_trigger: U14.7 (PA6), U15.14 (VOA)
/Pyro Fuse/buffer: C6.1, D1.1 (K), R79.1, U6.6 (VFIRE_1A)
/Pyro Fuse/clk: U6.4 (CLK), U14.2 (PA3)
/Pyro Fuse/cs: U6.30 (*CS), U14.5 (PA4)
/Pyro Fuse/miso: U6.9 (MISO), U14.1 (PA2)
/Pyro Fuse/mosi: U6.3 (MOSI), U14.20 (PA1)
/Pyro Fuse/program: J14.2, U14.19 (~RESET/PA0)
/Pyro Fuse/pyro_rx: U14.11 (PB3), U15.12 (VOC)
/Pyro Fuse/pyro_tx: U14.12 (PB2), U15.11 (VID)
/Pyro Fuse/r_limit: R81.2, U6.14 (R_LIMIT_1)
/Pyro Fuse/sqb_hi: J4.2, U6.5 (SQB_HI_1A)
/Pyro Fuse/sqb_lo: J4.1, U6.1 (SQB_LO_1A)
/Pyro Fuse/vdiag: R79.2, U6.7 (VDIAG_1)
GND: U15.2 (GND1), U15.8 (GND1); also elsewhere on the board
unnamed: R78.1, U6.29 (*RST)
unnamed: U6.8 (GND), U6.24 (VFIRE_RTN), U6.25 (VFIRE_RTN)
unnamed: U6.13 (FEN_1), U14.6 (PA5)
PYRO_RX: U15.5 (VIC)
PYRO_TX: U15.6 (VOD)
overcurrent_trigger: U14.8 (PA7); also elsewhere on the board
pyro_trigger: U15.3 (VIA); also elsewhere on the board

Notes on the sheet:
Pyro Fuse
43k = ~2.0A
R_DIAG External resistor to ground is used to set the diagnostic current for squib resistance.

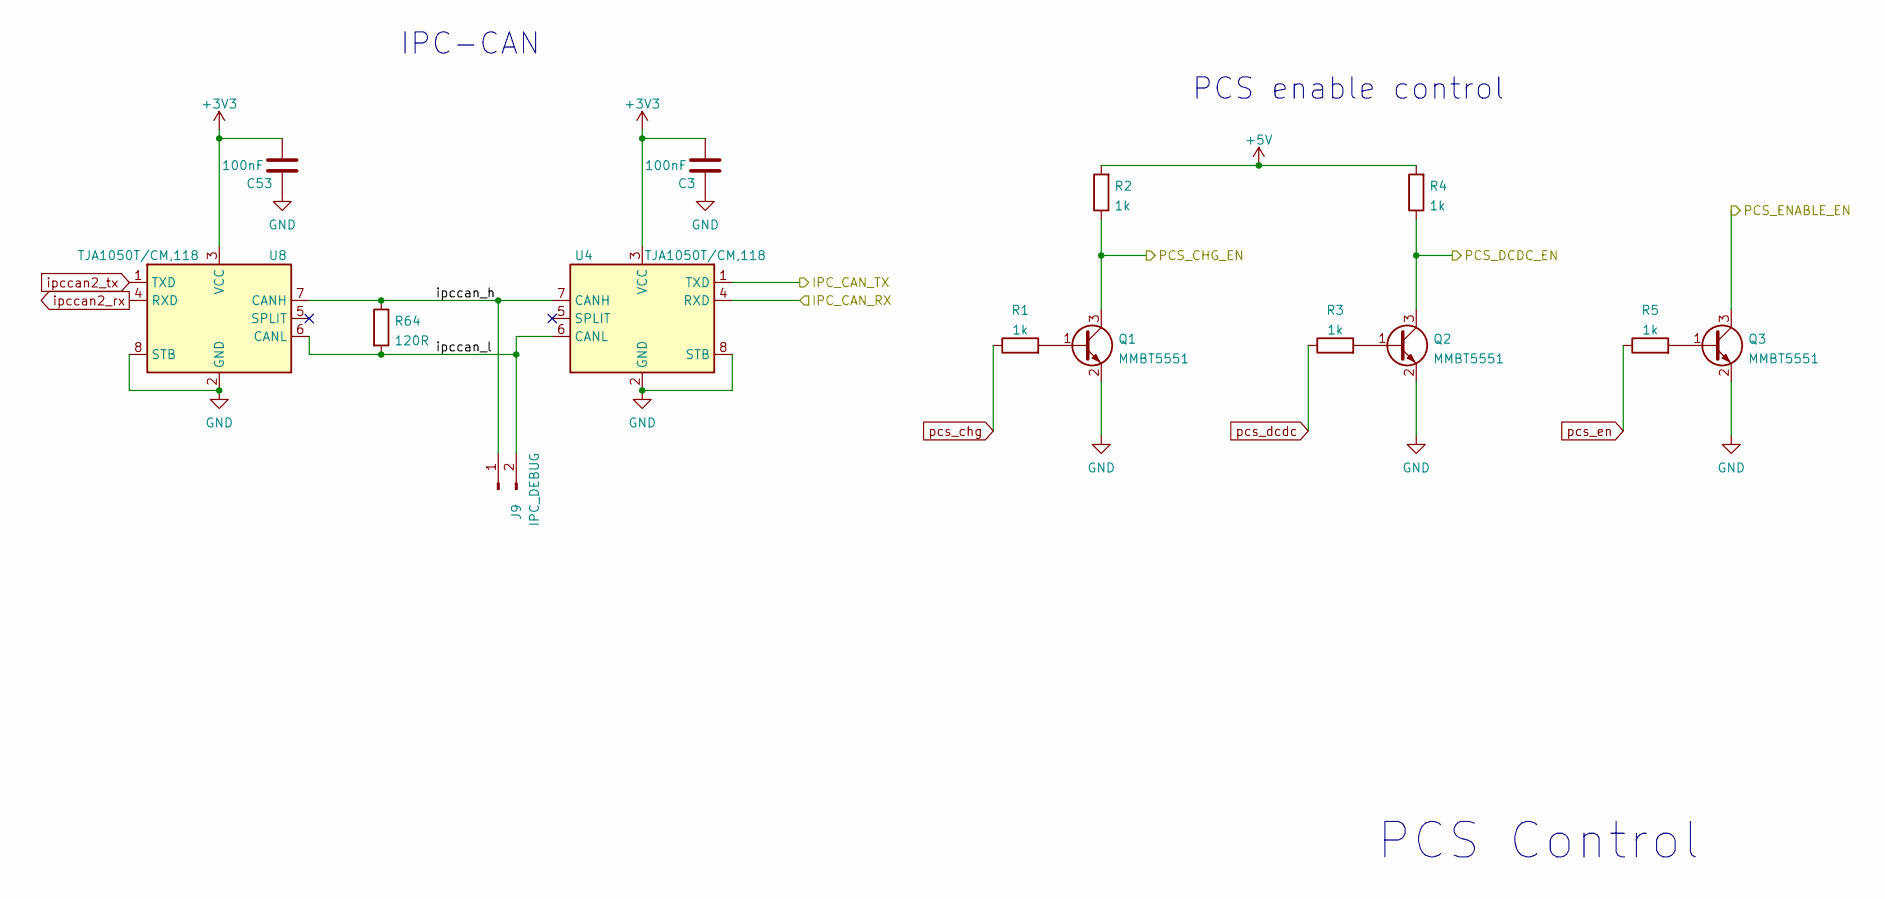
[picture p19: schematic pcs.kicad_sch, Tesla Model 3 Battery Controller]

Parts:
C3, C53: 100nF; C_0603_1608Metric; LCSC Part C14663
J9: IPC_DEBUG; TestPoint_2Pads_Pitch2.54mm_Drill0.8mm
Q1, Q2, Q3: MMBT5551; SOT-23; LCSC Part C2145
R1, R2, R3, R4, R5: 1k; R_0603_1608Metric; LCSC Part C21190
R64: 120R; R_0603_1608Metric; LCSC Part C22787
U4, U8: TJA1050T/CM,118; SOIC-8_3.9x4.9mm_P1.27mm; LCSC Part C6952

Connections:
+5V: R2.2, R4.2; also elsewhere on the board
/PCS control/IPC_CAN_RX: U4.4 (RXD); also elsewhere on the board
/PCS control/IPC_CAN_TX: U4.1 (TXD); also elsewhere on the board
/PCS control/PCS_CHG_EN: Q1.3 (C), R2.1; also elsewhere on the board
/PCS control/PCS_DCDC_EN: Q2.3 (C), R4.1; also elsewhere on the board
/PCS control/PCS_ENABLE_EN: Q3.3 (C); also elsewhere on the board
/PCS control/ipccan_h: J9.1, R64.1, U4.7 (CANH), U8.7 (CANH)
/PCS control/ipccan_l: J9.2, R64.2, U4.6 (CANL), U8.6 (CANL)
GND: C3.1, C53.1, Q1.2 (E), Q2.2 (E), Q3.2 (E), U4.2 (GND), U4.8 (STB), U8.2 (GND), U8.8 (STB); also elsewhere on the board
unnamed: Q1.1 (B), R1.2
unnamed: Q2.1 (B), R3.2
unnamed: Q3.1 (B), R5.2
ipccan2_rx: U8.4 (RXD); also elsewhere on the board
ipccan2_tx: U8.1 (TXD); also elsewhere on the board
pcs_chg: R1.1; also elsewhere on the board
pcs_dcdc: R3.1; also elsewhere on the board
pcs_en: R5.1; also elsewhere on the board

Notes on the sheet:
IPC-CAN
PCS enable control
PCS Control

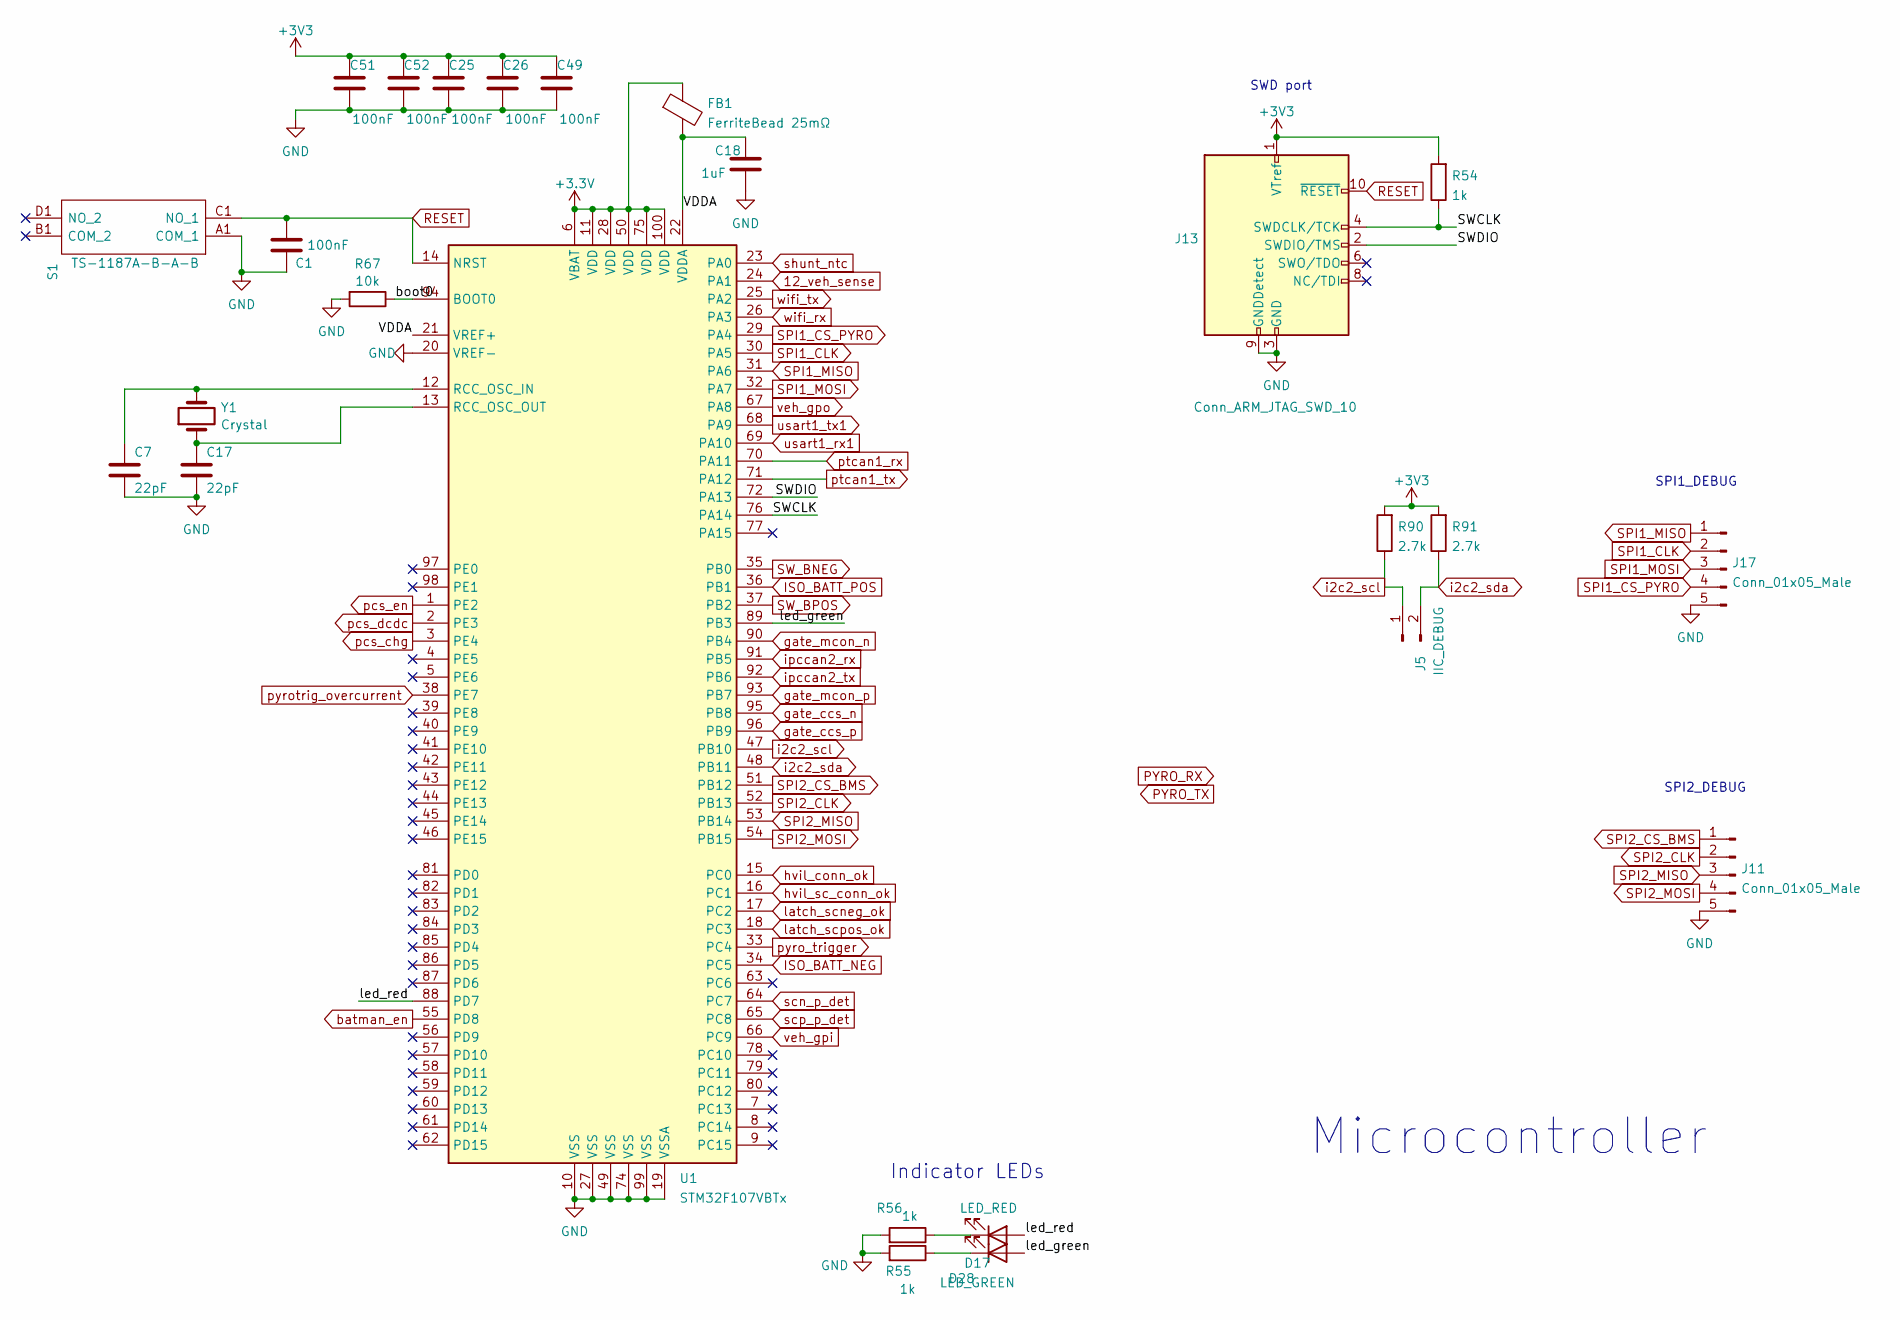
[picture p20: schematic microcontroller.kicad_sch, Tesla Model 3 Battery Controller]

Parts:
C1, C25, C26, C49, C51, C52: 100nF; C_0603_1608Metric; LCSC Part C14663
C7, C17: 22pF; C_0603_1608Metric; LCSC Part C1653
C18: 1uF; C_0603_1608Metric; LCSC Part C15849
D17: LED_GREEN; LED_0603_1608Metric_Pad1.05x0.95mm_HandSolder; LCSC Part C72043
D28: LED_RED; LED_0805_2012Metric_Pad1.15x1.40mm_HandSolder; LCSC Part C84256
FB1: FerriteBead 25mΩ; L_0805_2012Metric_Pad1.05x1.20mm_HandSolder; LCSC Part C840593
J5: IIC_DEBUG; TestPoint_2Pads_Pitch2.54mm_Drill0.8mm
J11, J17: Conn_01x05_Male; PinHeader_1x05_P1.27mm_Vertical
J13: Conn_ARM_JTAG_SWD_10; PinHeader_2x05_P1.27mm_JTAG_SMD
R54, R55, R56: 1k; R_0603_1608Metric; LCSC Part C21190
R67: 10k; R_0603_1608Metric; LCSC Part C25804
R90, R91: 2.7k; R_0603_1608Metric; LCSC Part C13167
S1: TS-1187A-B-A-B; TS1187ABAB; Manufacturer_Part_Number TS-1187A-B-A-B; LCSC Part C318884
U1: STM32F107VBTx; LQFP-100_14x14mm_P0.5mm
Y1: Crystal; Crystal_SMD_5032-2Pin_5.0x3.2mm; LCSC Part C115962

Connections:
12_veh_sense: U1.24 (PA1)
/STM32F107VCT6/SWCLK: J13.4 (SWDCLK/TCK), R54.1, U1.76 (PA14)
/STM32F107VCT6/SWDIO: J13.2 (SWDIO/TMS), U1.72 (PA13)
/STM32F107VCT6/VDDA: C18.1, FB1.2, U1.21 (VREF+), U1.22 (VDDA)
/STM32F107VCT6/boot0: R67.1, U1.94 (BOOT0)
/STM32F107VCT6/led_green: D17.2 (A), U1.89 (PB3)
/STM32F107VCT6/led_red: D28.2 (A), U1.88 (PD7)
GND: C1.1, C7.2, C17.2, C18.2, C25.1, C26.1, C49.1, C51.1, C52.1, J11.5, J13.3 (GND), J13.5 (GND), J13.9 (GNDDetect), J17.5, R55.2, R56.2, R67.2, S1.A1 (COM_1), U1.10 (VSS), U1.19 (VSSA), U1.20 (VREF-), U1.27 (VSS), U1.49 (VSS), U1.74 (VSS), U1.99 (VSS); also elsewhere on the board
ISO_BATT_NEG: U1.34 (PC5); also elsewhere on the board
ISO_BATT_POS: U1.36 (PB1); also elsewhere on the board
unnamed: D17.1 (K), R55.1
unnamed: D28.1 (K), R56.1
unnamed: C7.1, U1.12 (RCC_OSC_IN), Y1.2
unnamed: C17.1, U1.13 (RCC_OSC_OUT), Y1.1
RESET: C1.2, J13.10 (~RESET), S1.C1 (NO_1), U1.14 (NRST)
SPI1_CLK: J17.2, U1.30 (PA5)
SPI1_CS_PYRO: J17.4, U1.29 (PA4)
SPI1_MISO: J17.1, U1.31 (PA6)
SPI1_MOSI: J17.3, U1.32 (PA7)
SPI2_CLK: J11.2, U1.52 (PB13); also elsewhere on the board
SPI2_CS_BMS: J11.1, U1.51 (PB12); also elsewhere on the board
SPI2_MISO: J11.3, U1.53 (PB14); also elsewhere on the board
SPI2_MOSI: J11.4, U1.54 (PB15); also elsewhere on the board
SW_BNEG: U1.35 (PB0); also elsewhere on the board
SW_BPOS: U1.37 (PB2); also elsewhere on the board
batman_en: U1.55 (PD8); also elsewhere on the board
gate_ccs_n: U1.95 (PB8); also elsewhere on the board
gate_ccs_p: U1.96 (PB9); also elsewhere on the board
gate_mcon_n: U1.90 (PB4); also elsewhere on the board
gate_mcon_p: U1.93 (PB7); also elsewhere on the board
hvil_conn_ok: U1.15 (PC0); also elsewhere on the board
hvil_sc_conn_ok: U1.16 (PC1); also elsewhere on the board
i2c2_scl: J5.1, R90.1, U1.47 (PB10); also elsewhere on the board
i2c2_sda: J5.2, R91.1, U1.48 (PB11); also elsewhere on the board
ipccan2_rx: U1.91 (PB5); also elsewhere on the board
ipccan2_tx: U1.92 (PB6); also elsewhere on the board
latch_scneg_ok: U1.17 (PC2); also elsewhere on the board
latch_scpos_ok: U1.18 (PC3); also elsewhere on the board
pcs_chg: U1.3 (PE4); also elsewhere on the board
pcs_dcdc: U1.2 (PE3); also elsewhere on the board
pcs_en: U1.1 (PE2); also elsewhere on the board
ptcan1_rx: U1.70 (PA11); also elsewhere on the board
ptcan1_tx: U1.71 (PA12); also elsewhere on the board
pyro_trigger: U1.33 (PC4); also elsewhere on the board
pyrotrig_overcurrent: U1.38 (PE7)
scn_p_det: U1.64 (PC7); also elsewhere on the board
scp_p_det: U1.65 (PC8); also elsewhere on the board
shunt_ntc: U1.23 (PA0); also elsewhere on the board
usart1_rx1: U1.69 (PA10); also elsewhere on the board
usart1_tx1: U1.68 (PA9); also elsewhere on the board
veh_gpi: U1.66 (PC9); also elsewhere on the board
veh_gpo: U1.67 (PA8); also elsewhere on the board
wifi_rx: U1.26 (PA3); also elsewhere on the board
wifi_tx: U1.25 (PA2); also elsewhere on the board

Notes on the sheet:
SWD port
SPI2_DEBUG
Indicator LEDs
Microcontroller
SPI1_DEBUG
