Wim426F/HVCU-Hardware/hv_controller.kicad_pcb

## KiCad design hv_controller.kicad_pcb (continued)

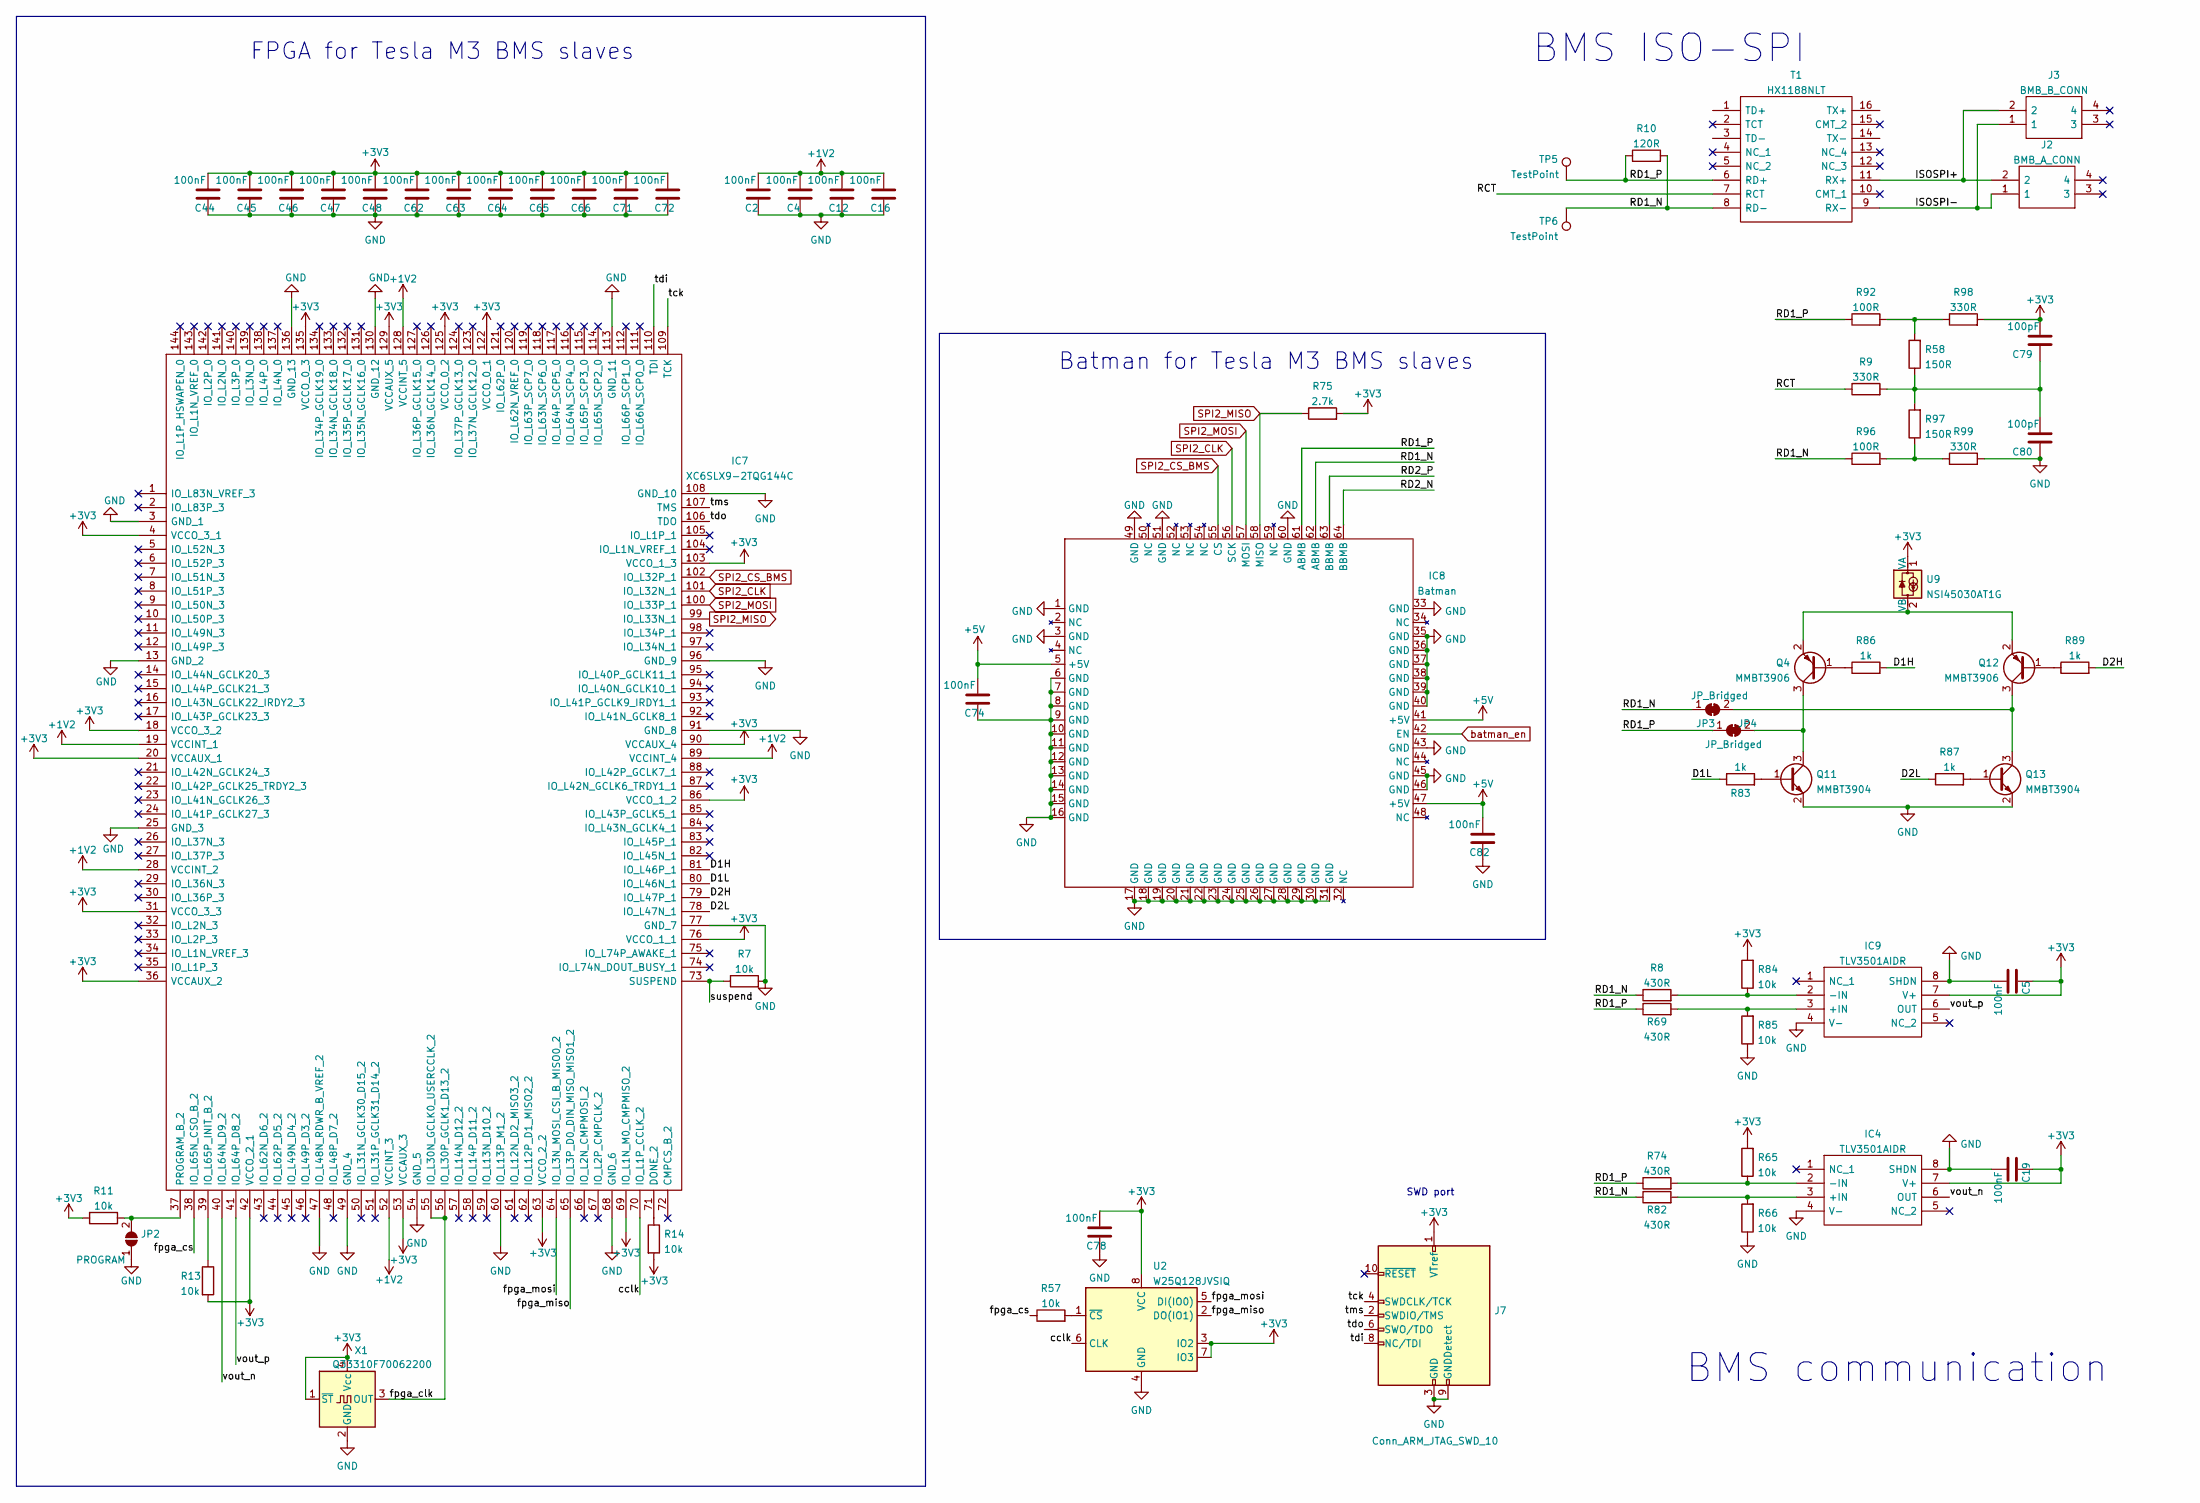
[picture p21: schematic bms.kicad_sch, Tesla Model 3 Battery Controller]

Parts:
C2, C4, C5, C12, C16, C19, C44, C45, C46, C47, C48, C62, C63, C64, C65, C66, C71, C72, C74, C78, C82: 100nF; C_0603_1608Metric; LCSC Part C14663
C79, C80: 100pF; C_0603_1608Metric; LCSC Part C14858
IC4, IC9: TLV3501AIDR; SOIC127P600X175-8N; Manufacturer_Part_Number TLV3501AIDR; Mouser Part Number 595-TLV3501AIDR
IC7: XC6SLX9-2TQG144C; QFP50P2200X2200X160-144N; Mouser Part Number 217-XC6SLX9-2TQG144C
IC8: Batman; LQFP-64_10x10mm_P0.5mm
J2: BMB_A_CONN; 0349128020; Manufacturer_Part_Number 34912-8020; Mouser Part Number 538-34912-8020
J3: BMB_B_CONN; 0349128020; Manufacturer_Part_Number 34912-8020; Mouser Part Number 538-34912-8020
J7: Conn_ARM_JTAG_SWD_10; PinHeader_2x05_P1.27mm_JTAG_SMD
JP2: PROGRAM; SolderJumper-2_P1.3mm_Open_RoundedPad1.0x1.5mm
JP3, JP4: JP_Bridged; SolderJumper-2_P1.3mm_Bridged_RoundedPad1.0x1.5mm
Q4, Q12: MMBT3906; SOT-23; LCSC Part C382282
Q11, Q13: MMBT3904; SOT-23; LCSC Part C20526
R7, R11, R13, R14, R57, R65, R66, R84, R85: 10k; R_0603_1608Metric; LCSC Part C25804
R8, R69, R74, R82: 430R; R_0603_1608Metric; LCSC Part C706174
R9, R98, R99: 330R; R_0603_1608Metric; LCSC Part C23138
R10: 120R; R_0603_1608Metric; LCSC Part C22787
R58, R97: 150R; R_0603_1608Metric; LCSC Part C22808
R75: 2.7k; R_0603_1608Metric; LCSC Part C13167
R83, R86, R87, R89: 1k; R_0603_1608Metric; LCSC Part C21190
R92, R96: 100R; R_0603_1608Metric; LCSC Part C22775
T1: HX1188NLT; Manufacturer_Part_Number HX1188NLT; Mouser Part Number 673-HX1188NLT
TP5, TP6: TestPoint
U2: W25Q128JVSIQ; SOIC-8_5.23x5.23mm_P1.27mm; LCSC Part C97521
U9: NSI45030AT1G; D_SOD-123; LCSC Part C150066
X1: Q33310F70062200; Oscillator_SMD_SeikoEpson_SG8002CE-4Pin_3.2x2.5mm; LCSC Part C46327

Connections:
+1V2: C2.1, C4.1, C12.1, C16.1, IC7.19 (VCCINT_1), IC7.28 (VCCINT_2), IC7.52 (VCCINT_3), IC7.89 (VCCINT_4), IC7.128 (VCCINT_5); also elsewhere on the board
+5V: C74.1, C82.1, IC8.5 (+5V), IC8.41 (+5V), IC8.47 (+5V); also elsewhere on the board
/BMS communication/D1H: IC7.81 (IO_L46P_1), R86.2
/BMS communication/D1L: IC7.80 (IO_L46N_1), R83.1
/BMS communication/D2H: IC7.79 (IO_L47P_1), R89.2
/BMS communication/D2L: IC7.78 (IO_L47N_1), R87.1
/BMS communication/ISOSPI+: J2.2, J3.2, T1.11 (RX+)
/BMS communication/ISOSPI-: J2.1, J3.1, T1.9 (RX-)
/BMS communication/RCT: R9.1, T1.7 (RCT)
/BMS communication/RD1_N: IC8.62 (ABMB), JP3.1 (A), R8.1, R10.2, R82.1, R96.1, T1.8 (RD-), TP6.1
/BMS communication/RD1_P: IC8.61 (ABMB), JP4.1 (A), R10.1, R69.1, R74.1, R92.1, T1.6 (RD+), TP5.1
/BMS communication/RD2_N: IC8.64 (BBMB)
/BMS communication/RD2_P: IC8.63 (BBMB)
/BMS communication/cclk: IC7.70 (IO_L1P_CCLK_2), U2.6 (CLK)
/BMS communication/fpga_clk: IC7.55 (IO_L30N_GCLK0_USERCCLK_2), IC7.56 (IO_L30P_GCLK1_D13_2), X1.3 (OUT)
/BMS communication/fpga_cs: IC7.38 (IO_L65N_CSO_B_2), R57.1
/BMS communication/fpga_miso: IC7.65 (IO_L3P_D0_DIN_MISO_MISO1_2), U2.2 (DO(IO1))
/BMS communication/fpga_mosi: IC7.64 (IO_L3N_MOSI_CSI_B_MISO0_2), U2.5 (DI(IO0))
/BMS communication/suspend: IC7.73 (SUSPEND), R7.1
/BMS communication/tck: IC7.109 (TCK), J7.4 (SWDCLK/TCK)
/BMS communication/tdi: IC7.110 (TDI), J7.8 (NC/TDI)
/BMS communication/tdo: IC7.106 (TDO), J7.6 (SWO/TDO)
/BMS communication/tms: IC7.107 (TMS), J7.2 (SWDIO/TMS)
/BMS communication/vout_n: IC4.6 (OUT), IC7.40 (IO_L64N_D9_2)
/BMS communication/vout_p: IC7.41 (IO_L64P_D8_2), IC9.6 (OUT)
GND: C2.2, C4.2, C5.1, C12.2, C16.2, C19.1, C44.2, C45.2, C46.2, C47.2, C48.2, C62.2, C63.2, C64.2, C65.2, C66.2, C71.2, C72.2, C74.2, C78.2, C80.1, C82.2, IC4.4 (V-), IC4.8 (SHDN), IC7.3 (GND_1), IC7.13 (GND_2), IC7.25 (GND_3), IC7.47 (IO_L48N_RDWR_B_VREF_2), IC7.49 (GND_4), IC7.54 (GND_5), IC7.60 (IO_L13P_M1_2), IC7.68 (GND_6), IC7.77 (GND_7), IC7.91 (GND_8), IC7.96 (GND_9), IC7.108 (GND_10), IC7.113 (GND_11), IC7.130 (GND_12), IC7.136 (GND_13), IC8.1 (GND), IC8.3 (GND), IC8.6 (GND), IC8.7 (GND), IC8.8 (GND), IC8.9 (GND), IC8.10 (GND), IC8.11 (GND), IC8.12 (GND), IC8.13 (GND), IC8.14 (GND), IC8.15 (GND), IC8.16 (GND), IC8.17 (GND), IC8.18 (GND), IC8.19 (GND), IC8.20 (GND), IC8.21 (GND), IC8.22 (GND), IC8.23 (GND), IC8.24 (GND), IC8.25 (GND), IC8.26 (GND), IC8.27 (GND), IC8.28 (GND), IC8.29 (GND), IC8.30 (GND), IC8.31 (GND), IC8.33 (GND), IC8.35 (GND), IC8.36 (GND), IC8.37 (GND), IC8.38 (GND), IC8.39 (GND), IC8.40 (GND), IC8.43 (GND), IC8.45 (GND), IC8.46 (GND), IC8.49 (GND), IC8.51 (GND), IC8.60 (GND), IC9.4 (V-), IC9.8 (SHDN), J7.3 (GND), J7.5 (GND), J7.9 (GNDDetect), JP2.1 (A), Q11.2 (E), Q13.2 (E), R7.2, R66.1, R85.1, R99.2, U2.4 (GND), X1.2 (GND); also elsewhere on the board
unnamed: C79.1, C80.2, R9.2, R58.1, R97.2
unnamed: IC4.3 (+IN), R66.2, R82.2
unnamed: IC4.2 (-IN), R65.1, R74.2
unnamed: IC7.71 (DONE_2), R14.1
unnamed: IC7.39 (IO_L65P_INIT_B_2), R13.1
unnamed: IC7.37 (PROGRAM_B_2), JP2.2 (B), R11.1
unnamed: IC9.3 (+IN), R69.2, R85.2
unnamed: IC9.2 (-IN), R8.2, R84.1
unnamed: JP3.2 (B), Q12.3 (C), Q13.3 (C)
unnamed: JP4.2 (B), Q4.3 (C), Q11.3 (C)
unnamed: Q4.1 (B), R86.1
unnamed: Q11.1 (B), R83.2
unnamed: Q12.1 (B), R89.1
unnamed: Q4.2 (E), Q12.2 (E), U9.2 (VB)
unnamed: Q13.1 (B), R87.2
unnamed: R58.2, R92.2, R98.1
unnamed: R96.2, R97.1, R99.1
unnamed: R57.2, U2.1 (~CS)
SPI2_CLK: IC7.101 (IO_L32N_1), IC8.56 (SCK); also elsewhere on the board
SPI2_CS_BMS: IC7.102 (IO_L32P_1), IC8.55 (CS); also elsewhere on the board
SPI2_MISO: IC7.99 (IO_L33N_1), IC8.58 (MISO), R75.1; also elsewhere on the board
SPI2_MOSI: IC7.100 (IO_L33P_1), IC8.57 (MOSI); also elsewhere on the board
batman_en: IC8.42 (EN); also elsewhere on the board

Notes on the sheet:
BMS communication
Batman for Tesla M3 BMS slaves
BMS ISO-SPI
SWD port
FPGA for Tesla M3 BMS slaves

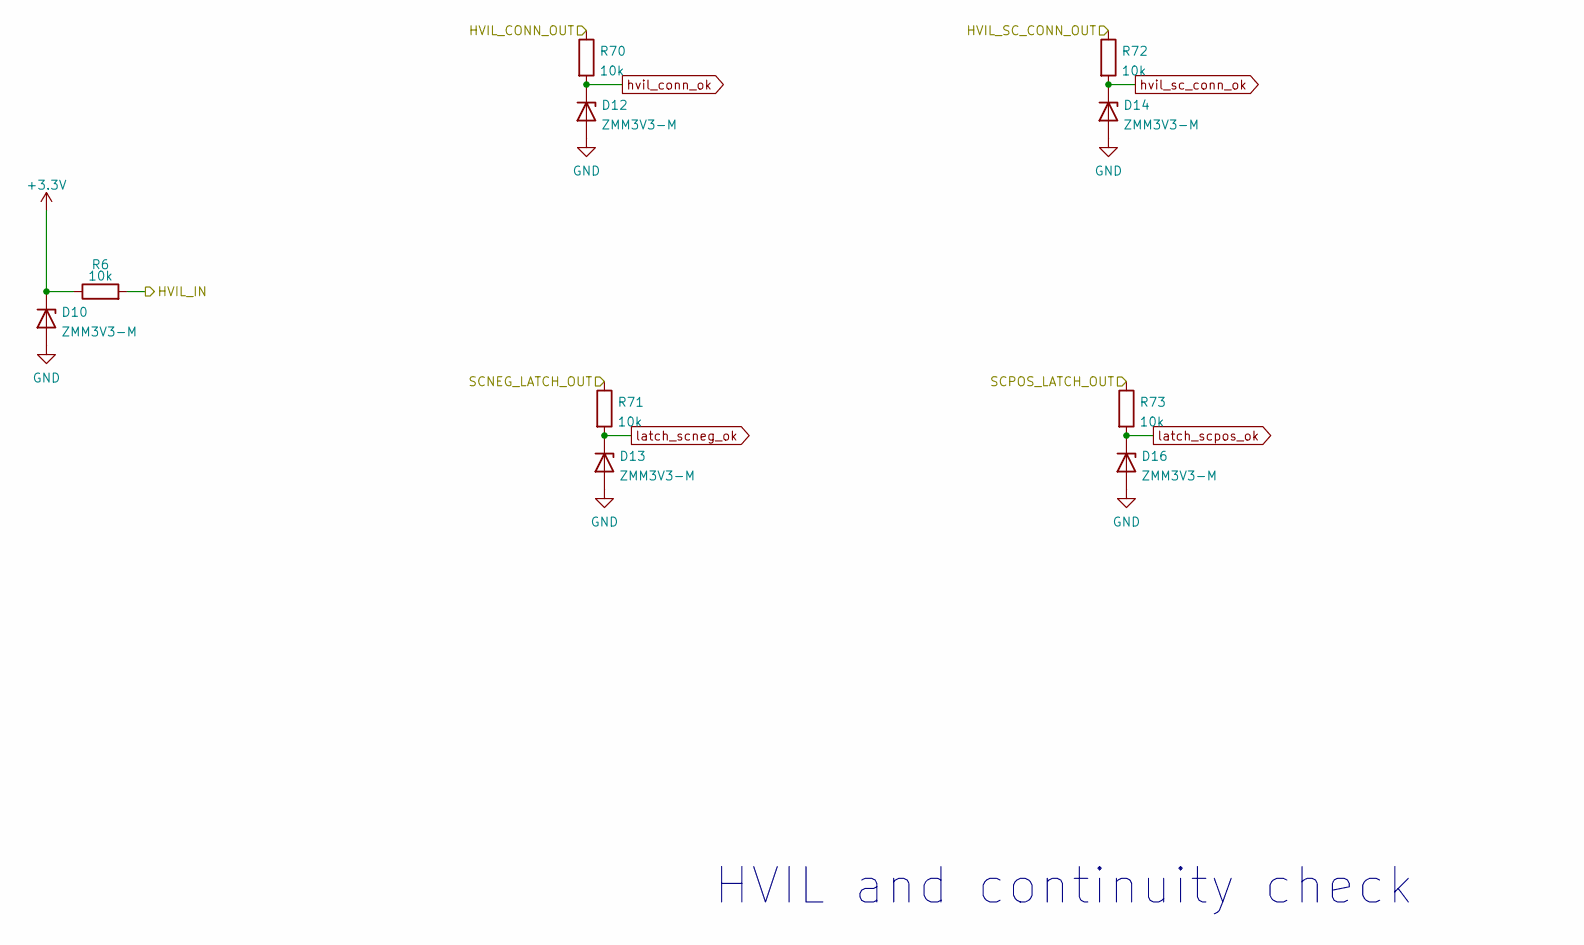
[picture p22: schematic hvil.kicad_sch, Tesla Model 3 Battery Controller]

Parts:
D10, D12, D13, D14, D16: ZMM3V3-M; D_MiniMELF; LCSC Part C8056
R6, R70, R71, R72, R73: 10k; R_0603_1608Metric; LCSC Part C25804

Connections:
/HVIL safety/HVIL_CONN_OUT: R70.1; also elsewhere on the board
/HVIL safety/HVIL_IN: R6.2; also elsewhere on the board
/HVIL safety/HVIL_SC_CONN_OUT: R72.1; also elsewhere on the board
/HVIL safety/SCNEG_LATCH_OUT: R71.1; also elsewhere on the board
/HVIL safety/SCPOS_LATCH_OUT: R73.1; also elsewhere on the board
GND: D10.2 (A), D12.2 (A), D13.2 (A), D14.2 (A), D16.2 (A); also elsewhere on the board
hvil_conn_ok: D12.1 (K), R70.2; also elsewhere on the board
hvil_sc_conn_ok: D14.1 (K), R72.2; also elsewhere on the board
latch_scneg_ok: D13.1 (K), R71.2; also elsewhere on the board
latch_scpos_ok: D16.1 (K), R73.2; also elsewhere on the board

Notes on the sheet:
HVIL and continuity check

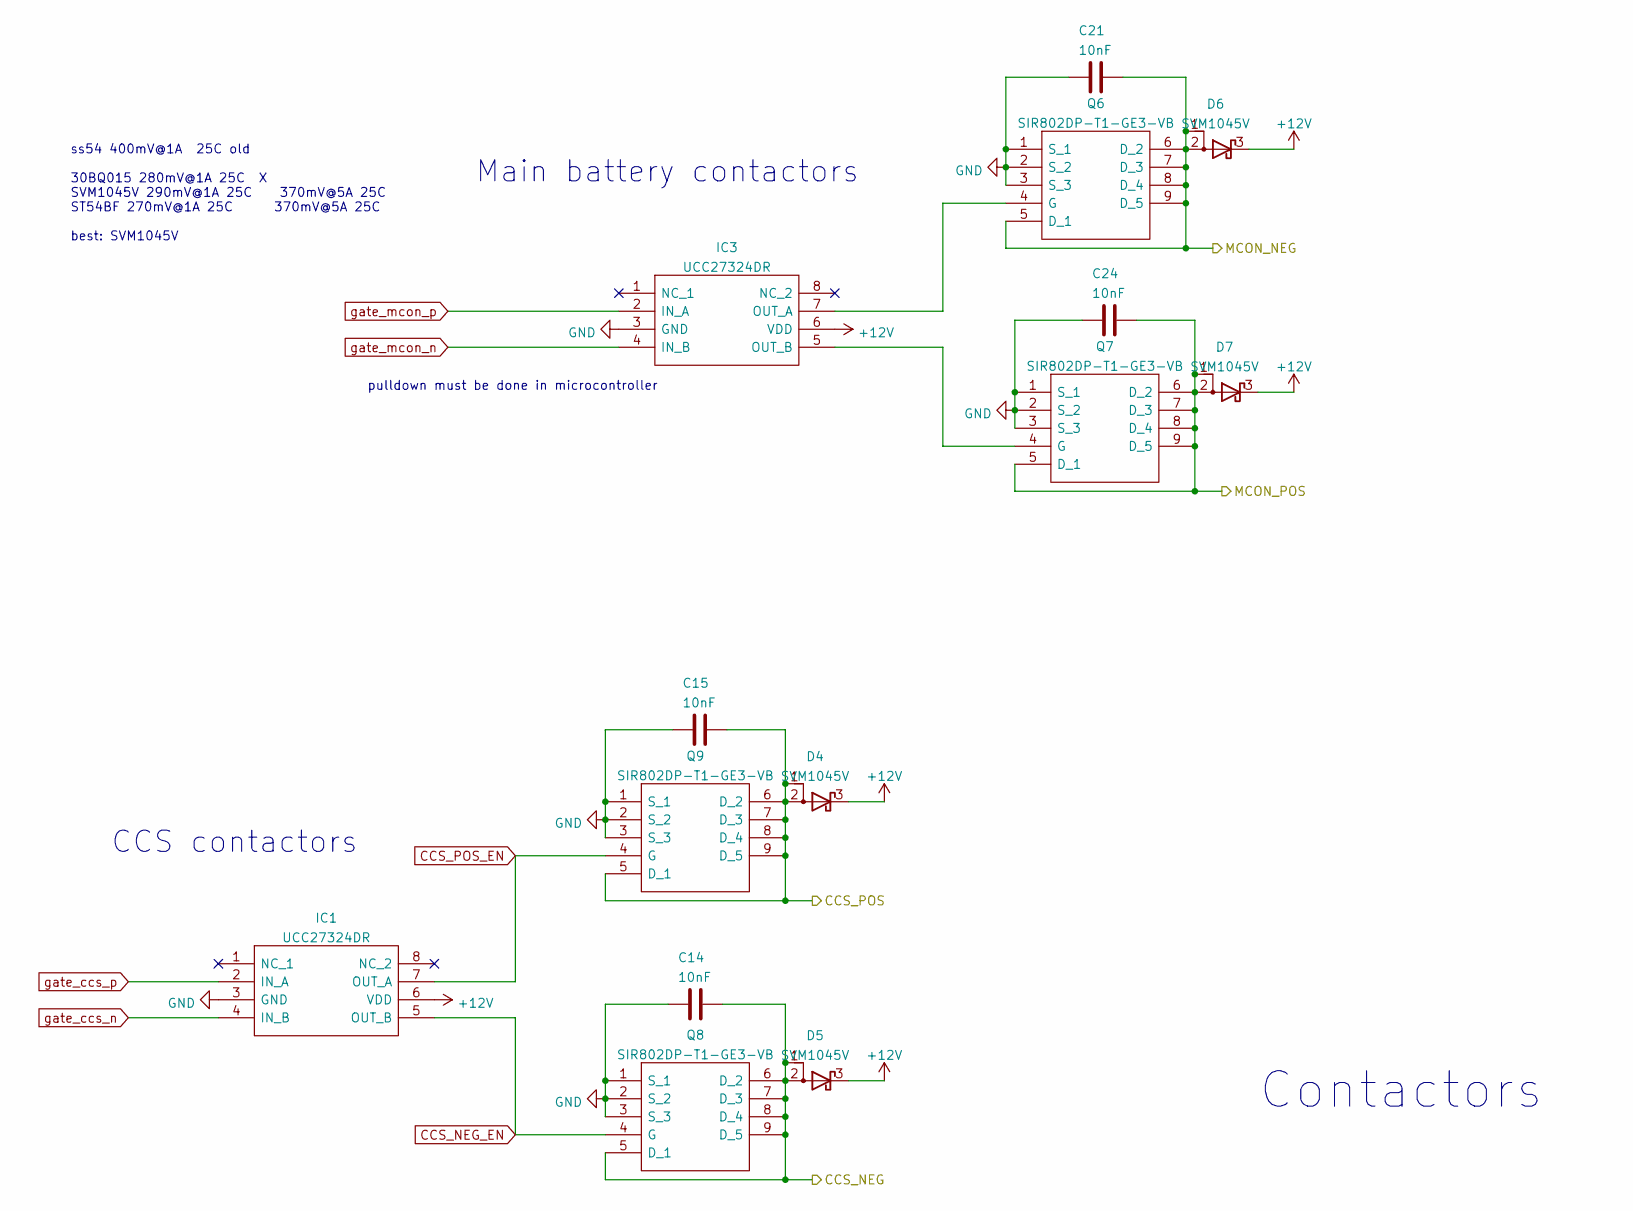
[picture p23: schematic contactors.kicad_sch, Tesla Model 3 Battery Controller]

Parts:
C14, C15, C21, C24: 10nF; C_0603_1608Metric; LCSC Part C57112
D4, D5, D6, D7: SVM1045V; TO-277B; LCSC Part C268715
IC1, IC3: UCC27324DR; SOP-8_3.9x4.9mm_P1.27mm; Manufacturer_Part_Number UCC27324DR; LCSC Part C46427
Q6, Q7, Q8, Q9: SIR802DP-T1-GE3-VB; SIRA90DPT1GE3; Manufacturer_Part_Number SIR802DP-T1-GE3-VB; LCSC Part C558278

Connections:
+12V: D4.3 (K), D5.3 (K), D6.3 (K), D7.3 (K), IC1.6 (VDD), IC3.6 (VDD); also elsewhere on the board
/Contactors/CCS_NEG: C14.1, D5.1 (A), D5.2 (A), Q8.5 (D_1), Q8.6 (D_2), Q8.7 (D_3), Q8.8 (D_4), Q8.9 (D_5); also elsewhere on the board
/Contactors/CCS_POS: C15.1, D4.1 (A), D4.2 (A), Q9.5 (D_1), Q9.6 (D_2), Q9.7 (D_3), Q9.8 (D_4), Q9.9 (D_5); also elsewhere on the board
/Contactors/MCON_NEG: C21.1, D6.1 (A), D6.2 (A), Q6.5 (D_1), Q6.6 (D_2), Q6.7 (D_3), Q6.8 (D_4), Q6.9 (D_5); also elsewhere on the board
/Contactors/MCON_POS: C24.1, D7.1 (A), D7.2 (A), Q7.5 (D_1), Q7.6 (D_2), Q7.7 (D_3), Q7.8 (D_4), Q7.9 (D_5); also elsewhere on the board
CCS_NEG_EN: IC1.5 (OUT_B), Q8.4 (G)
CCS_POS_EN: IC1.7 (OUT_A), Q9.4 (G)
GND: C14.2, C15.2, C21.2, C24.2, IC1.3 (GND), IC3.3 (GND), Q6.1 (S_1), Q6.2 (S_2), Q6.3 (S_3), Q7.1 (S_1), Q7.2 (S_2), Q7.3 (S_3), Q8.1 (S_1), Q8.2 (S_2), Q8.3 (S_3), Q9.1 (S_1), Q9.2 (S_2), Q9.3 (S_3); also elsewhere on the board
unnamed: IC3.7 (OUT_A), Q6.4 (G)
unnamed: IC3.5 (OUT_B), Q7.4 (G)
gate_ccs_n: IC1.4 (IN_B); also elsewhere on the board
gate_ccs_p: IC1.2 (IN_A); also elsewhere on the board
gate_mcon_n: IC3.4 (IN_B); also elsewhere on the board
gate_mcon_p: IC3.2 (IN_A); also elsewhere on the board

Notes on the sheet:
ss54 400mV@1A 25C old 30BQ015 280mV@1A 25C X SVM1045V 290mV@1A 25C 370mV@5A 25C ST54BF 270mV@1A 25C 370mV@5A 25C best: SVM1045V
Main battery contactors
CCS contactors
Contactors
pulldown must be done in microcontroller

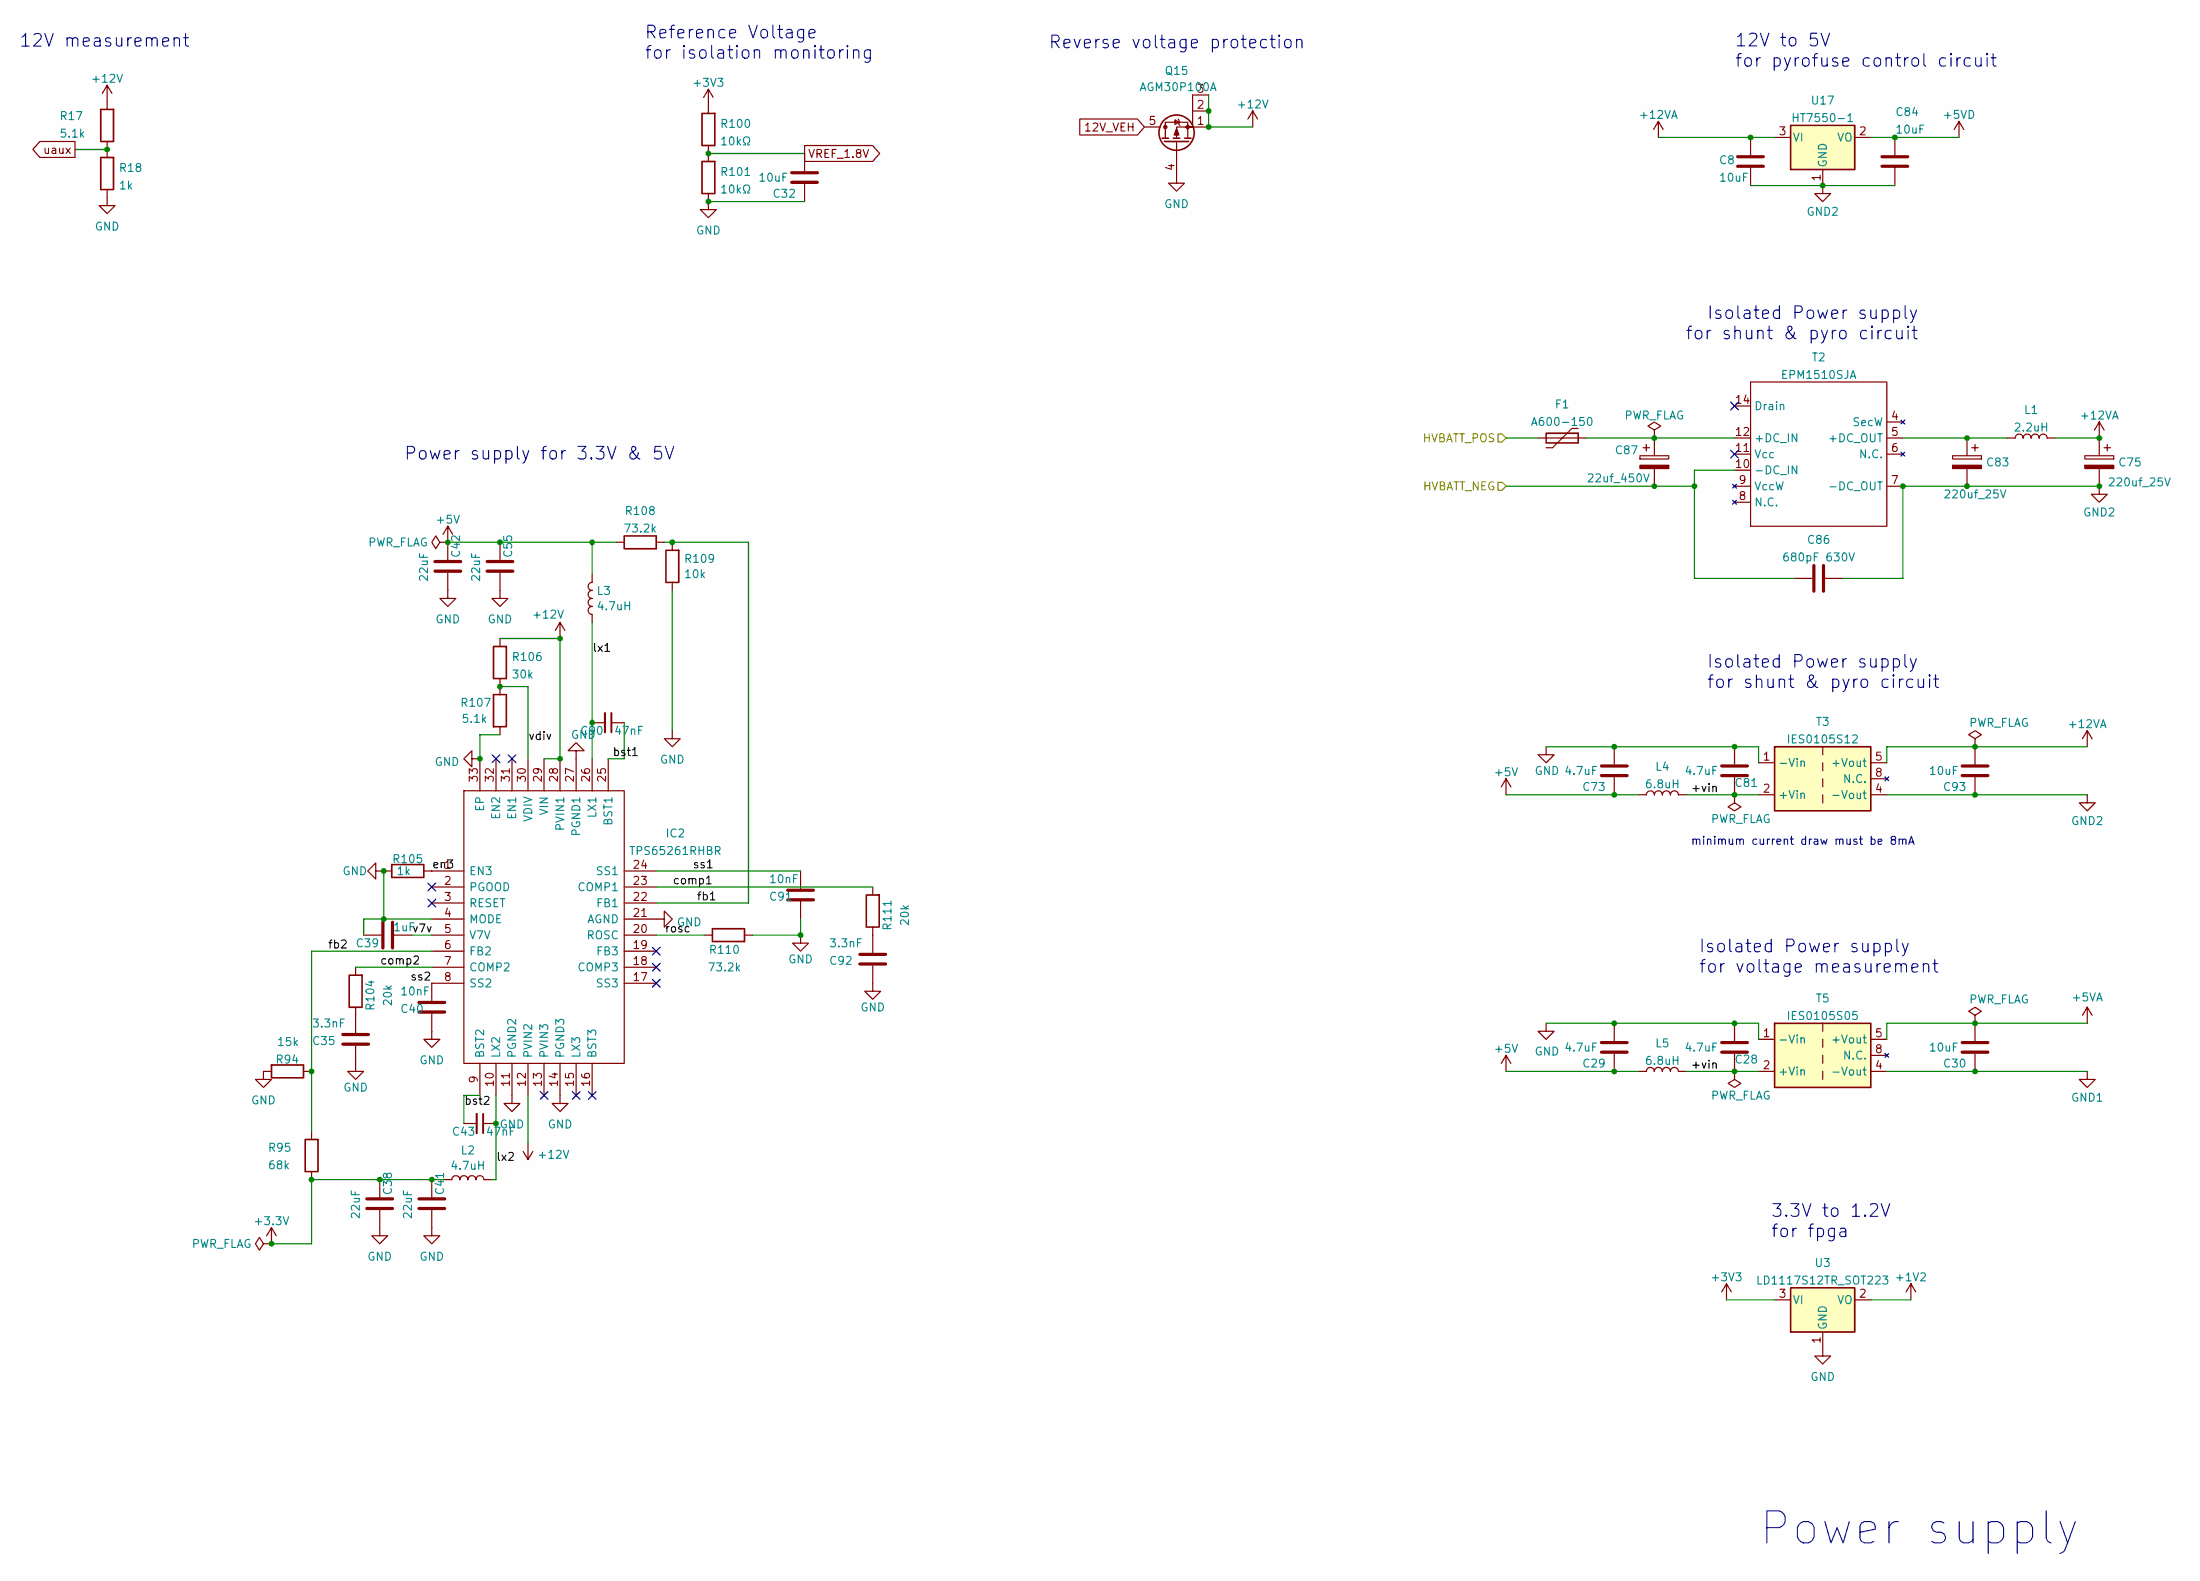
[picture p24: schematic power_supply.kicad_sch, Tesla Model 3 Battery Controller]

Parts:
C8, C30, C32, C84: 10uF; C_0603_1608Metric; LCSC Part C19702
C28, C29: 4.7uF; C_0603_1608Metric; LCSC Part C19666
C35, C92: 3.3nF; C_0603_1608Metric; LCSC Part C1613
C38, C41, C42, C55: 22uF; C_0603_1608Metric; LCSC Part C59461
C39: 1uF; C_0603_1608Metric; LCSC Part C15849
C40, C91: 10nF; C_0603_1608Metric; LCSC Part C57112
C43, C90: 47nF; C_0603_1608Metric; LCSC Part C1622
C73, C81: 4.7uF; C_0805_2012Metric_Pad1.18x1.45mm_HandSolder; LCSC Part C1779
C75, C83: 220uf_25V; CP_Elec_6.3x7.7; Part nr. GYA1E221MCQ1GS; LCSC Part C371974
C86: 680pF 630V; C_1206_3216Metric_Pad1.33x1.80mm_HandSolder; Part nr CS85-B2GA681KANKA; LCSC Part C106005
C87: 22uf_450V; C_Radial_D12.5mm_H20.0mm_P5.00mm; Mouser UUG2G220MNQ6MS
C93: 10uF; C_0805_2012Metric_Pad1.18x1.45mm_HandSolder; LCSC Part C440198
F1: A600-150; Fuse_RL600-150_L14mm_W5.1mm; LCSC Part C135449
IC2: TPS65261RHBR; HVQFN-32-1EP_5x5mm_P0.5mm_EP3.1x3.1mm; Manufacturer_Part_Number TPS65261RHBR; Mouser Part Number 595-TPS65261RHBR
L1: 2.2uH; L_0805_2012Metric_Pad1.15x1.40mm_HandSolder; LCSC Part C136243
L2, L3: 4.7uH; L_Vishay_IFSC-1515AH_4x4x1.8mm; LCSC Part C602031
L4, L5: 6.8uH; L_0805_2012Metric_Pad1.15x1.40mm_HandSolder; LCSC Part C139247
Q15: AGM30P100A; PQFN-8-EP_6x5mm_P1.27mm_Generic; LCSC Part C5297493
R17, R107: 5.1k; R_0603_1608Metric; LCSC Part C23186
R18, R105: 1k; R_0603_1608Metric; LCSC Part C21190
R94: 15k; R_0603_1608Metric; LCSC Part C22809
R95: 68k; R_0603_1608Metric; LCSC Part C23231
R100, R101: 10kΩ; R_0402_1005Metric_Pad0.72x0.64mm_HandSolder; LCSC Part C328417
R104, R111: 20k; R_0603_1608Metric; LCSC Part C4184
R106: 30k; R_0603_1608Metric; LCSC Part C22984
R108, R110: 73.2k; R_0603_1608Metric; LCSC Part C321992
R109: 10k; R_0603_1608Metric; LCSC Part C25804
T2: EPM1510SJA; Converter_DCDC_EPM1205SJ; Manufacturer_Part_Number EPM1510SJA; Mouser Part Number 838-EPM1205SJ
T3: IES0105S12; SMDIP-8_W9.53mm
T5: IES0105S05; SMDIP-8_W9.53mm
U3: LD1117S12TR_SOT223; SOT-223-3_TabPin2; LCSC Part C155612
U17: HT7550-1; SOT-89-3; LCSC Part C16106

Connections:
12V_VEH: Q15.5 (D); also elsewhere on the board
+1V2: U3.2 (VO); also elsewhere on the board
+5V: C29.1, C42.1, C55.1, C73.1, L3.2, L4.1, L5.1, R108.1; also elsewhere on the board
+5VA: C30.2, T5.5 (+Vout); also elsewhere on the board
+5VD: C84.1, U17.2 (VO); also elsewhere on the board
+12V: IC2.12 (PVIN2), IC2.28 (PVIN1), IC2.29 (VIN), Q15.1 (S), Q15.2 (S), Q15.3 (S), R17.2, R106.2; also elsewhere on the board
+12VA: C8.1, C75.1, C93.2, L1.2, T3.5 (+Vout), U17.3 (VI); also elsewhere on the board
/HVBATT_NEG: C86.1, C87.2, T2.10 (-DC_IN); also elsewhere on the board
/HVBATT_POS: F1.2; also elsewhere on the board
/Power supply/+vin: C28.1, C81.1, L4.2, L5.2, T3.2 (+Vin), T5.2 (+Vin)
/Power supply/bst1: C90.1, IC2.25 (BST1)
/Power supply/bst2: C43.2, IC2.9 (BST2)
/Power supply/comp1: IC2.23 (COMP1), R111.2
/Power supply/comp2: IC2.7 (COMP2), R104.2
/Power supply/en3: IC2.1 (EN3), R105.1
/Power supply/fb1: IC2.22 (FB1), R108.2, R109.2
/Power supply/fb2: IC2.6 (FB2), R94.1, R95.2
/Power supply/lx1: C90.2, IC2.26 (LX1), L3.1
/Power supply/lx2: C43.1, IC2.10 (LX2), L2.2
/Power supply/rosc: IC2.20 (ROSC), R110.1
/Power supply/ss1: C91.1, IC2.24 (SS1)
/Power supply/ss2: C40.1, IC2.8 (SS2)
/Power supply/v7v: C39.2, IC2.5 (V7V)
/Power supply/vdiv: IC2.30 (VDIV), R106.1, R107.1
GND: C28.2, C29.2, C32.1, C35.2, C38.2, C39.1, C40.2, C41.2, C42.2, C55.2, C73.2, C81.2, C91.2, C92.2, IC2.4 (MODE), IC2.11 (PGND2), IC2.14 (PGND3), IC2.21 (AGND), IC2.27 (PGND1), IC2.33 (EP), Q15.4 (G), R18.1, R94.2, R101.1, R105.2, R107.2, R109.1, R110.2, T3.1 (-Vin), T5.1 (-Vin), U3.1 (GND); also elsewhere on the board
GND1: C30.1, T5.4 (-Vout); also elsewhere on the board
unnamed: C35.1, R104.1
unnamed: C92.1, R111.1
unnamed: C87.1, F1.1, T2.12 (+DC_IN)
unnamed: C83.1, L1.1, T2.5 (+DC_OUT)
VREF_1.8V: C32.2, R100.1, R101.2; also elsewhere on the board
uaux: R17.1, R18.2

Notes on the sheet:
Isolated Power supply for shunt & pyro circuit
Power supply for 3.3V & 5V
minimum current draw must be 8mA
3.3V to 1.2V for fpga
12V measurement
Reference Voltage for isolation monitoring
Power supply
Isolated Power supply for voltage measurement
Reverse voltage protection
12V to 5V for pyrofuse control circuit

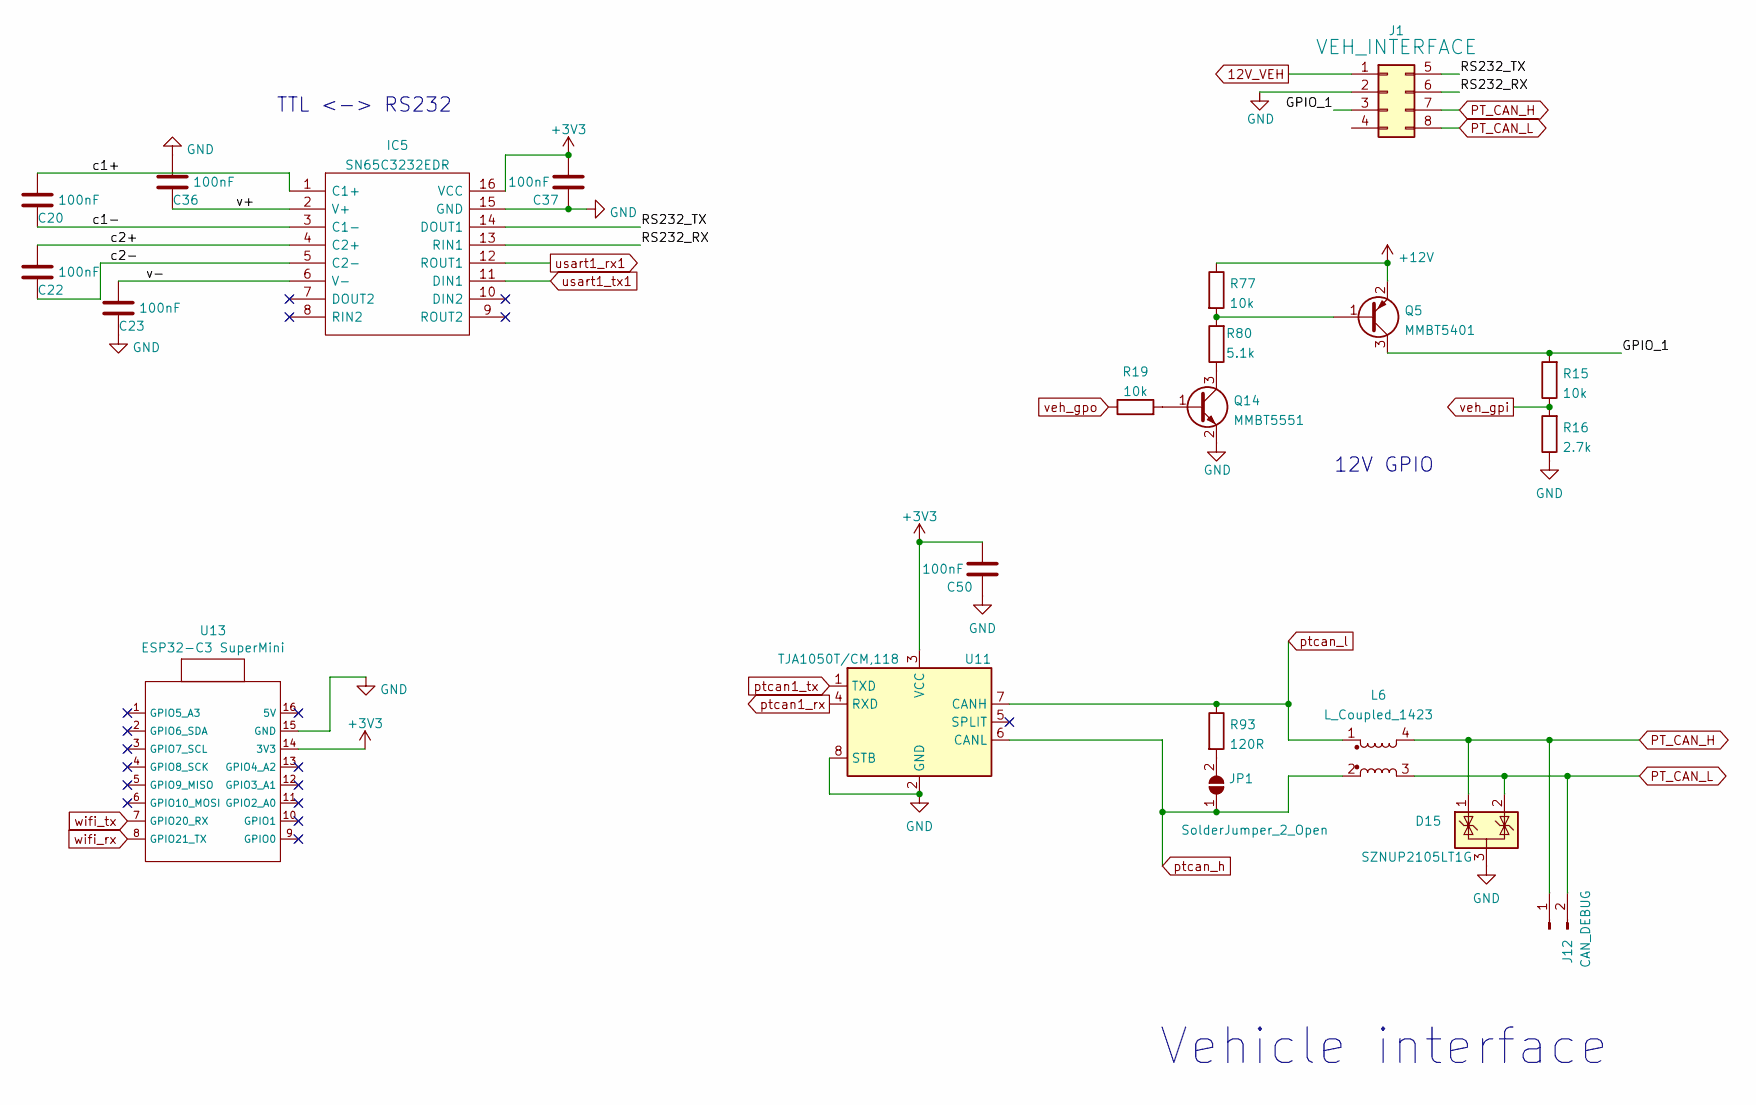
[picture p25: schematic veh_interface.kicad_sch, Tesla Model 3 Battery Controller]

Parts:
C20, C22, C23, C36, C37, C50: 100nF; C_0603_1608Metric; LCSC Part C14663
D15: SZNUP2105LT1G; SOT-23; LCSC Part C233494
IC5: SN65C3232EDR; SOIC127P600X175-16N; Manufacturer_Part_Number SN65C3232EDR; Mouser Part Number 595-SN65C3232EDR
J1: VEH_INTERFACE; Molex_Mini-Fit_Jr_5569-08A2_2x04_P4.20mm_Horizontal
J12: CAN_DEBUG; TestPoint_2Pads_Pitch2.54mm_Drill0.8mm
JP1: SolderJumper_2_Open; SolderJumper-2_P1.3mm_Open_RoundedPad1.0x1.5mm
L6: L_Coupled_1423; PE1812ACC220STS; Manufacturer_Part_Number PE-1812ACC220STS; Mouser Part Number 673-PE-1812ACC220STS
Q5: MMBT5401; SOT-23; LCSC Part C8326
Q14: MMBT5551; SOT-23; LCSC Part C2145
R15, R19, R77: 10k; R_0603_1608Metric; LCSC Part C25804
R16: 2.7k; R_0603_1608Metric; LCSC Part C13167
R80: 5.1k; R_0603_1608Metric; LCSC Part C23186
R93: 120R; R_0603_1608Metric; LCSC Part C22787
U11: TJA1050T/CM,118; SOIC-8_3.9x4.9mm_P1.27mm; LCSC Part C6952
U13: ESP32-C3 SuperMini; ESP32-C3-14P-SMD-2.54-21X17.8MM

Connections:
12V_VEH: J1.1; also elsewhere on the board
+12V: Q5.2 (E), R77.1; also elsewhere on the board
/Vehicle interface/GPIO_1: J1.3, Q5.3 (C), R15.2
/Vehicle interface/RS232_RX: IC5.13 (RIN1), J1.6
/Vehicle interface/RS232_TX: IC5.14 (DOUT1), J1.5
/Vehicle interface/c1+: C20.2, IC5.1 (C1+)
/Vehicle interface/c1-: C20.1, IC5.3 (C1-)
/Vehicle interface/c2+: C22.2, IC5.4 (C2+)
/Vehicle interface/c2-: C22.1, IC5.5 (C2-)
/Vehicle interface/v+: C36.1, IC5.2 (V+)
/Vehicle interface/v-: C23.2, IC5.6 (V-)
GND: C23.1, C36.2, C37.1, C50.1, D15.3 (A), IC5.15 (GND), J1.2, Q14.2 (E), R16.1, U11.2 (GND), U11.8 (STB), U13.15 (GND); also elsewhere on the board
unnamed: JP1.2 (B), R93.2
unnamed: Q5.1 (B), R77.2, R80.2
unnamed: Q14.1 (B), R19.2
unnamed: Q14.3 (C), R80.1
PT_CAN_H: D15.1 (K), J1.7, J12.1, L6.4
PT_CAN_L: D15.2 (K), J1.8, J12.2, L6.3
ptcan1_rx: U11.4 (RXD); also elsewhere on the board
ptcan1_tx: U11.1 (TXD); also elsewhere on the board
ptcan_h: JP1.1 (A), L6.2, U11.6 (CANL)
ptcan_l: L6.1, R93.1, U11.7 (CANH)
usart1_rx1: IC5.12 (ROUT1); also elsewhere on the board
usart1_tx1: IC5.11 (DIN1); also elsewhere on the board
veh_gpi: R15.1, R16.2; also elsewhere on the board
veh_gpo: R19.1; also elsewhere on the board
wifi_rx: U13.8 (GPIO21_TX); also elsewhere on the board
wifi_tx: U13.7 (GPIO20_RX); also elsewhere on the board

Notes on the sheet:
TTL <-> RS232
Vehicle interface
12V GPIO
