Wim426F/HVCU-Hardware/hv_controller.kicad_pcb

## KiCad design hv_controller.kicad_pcb (continued)

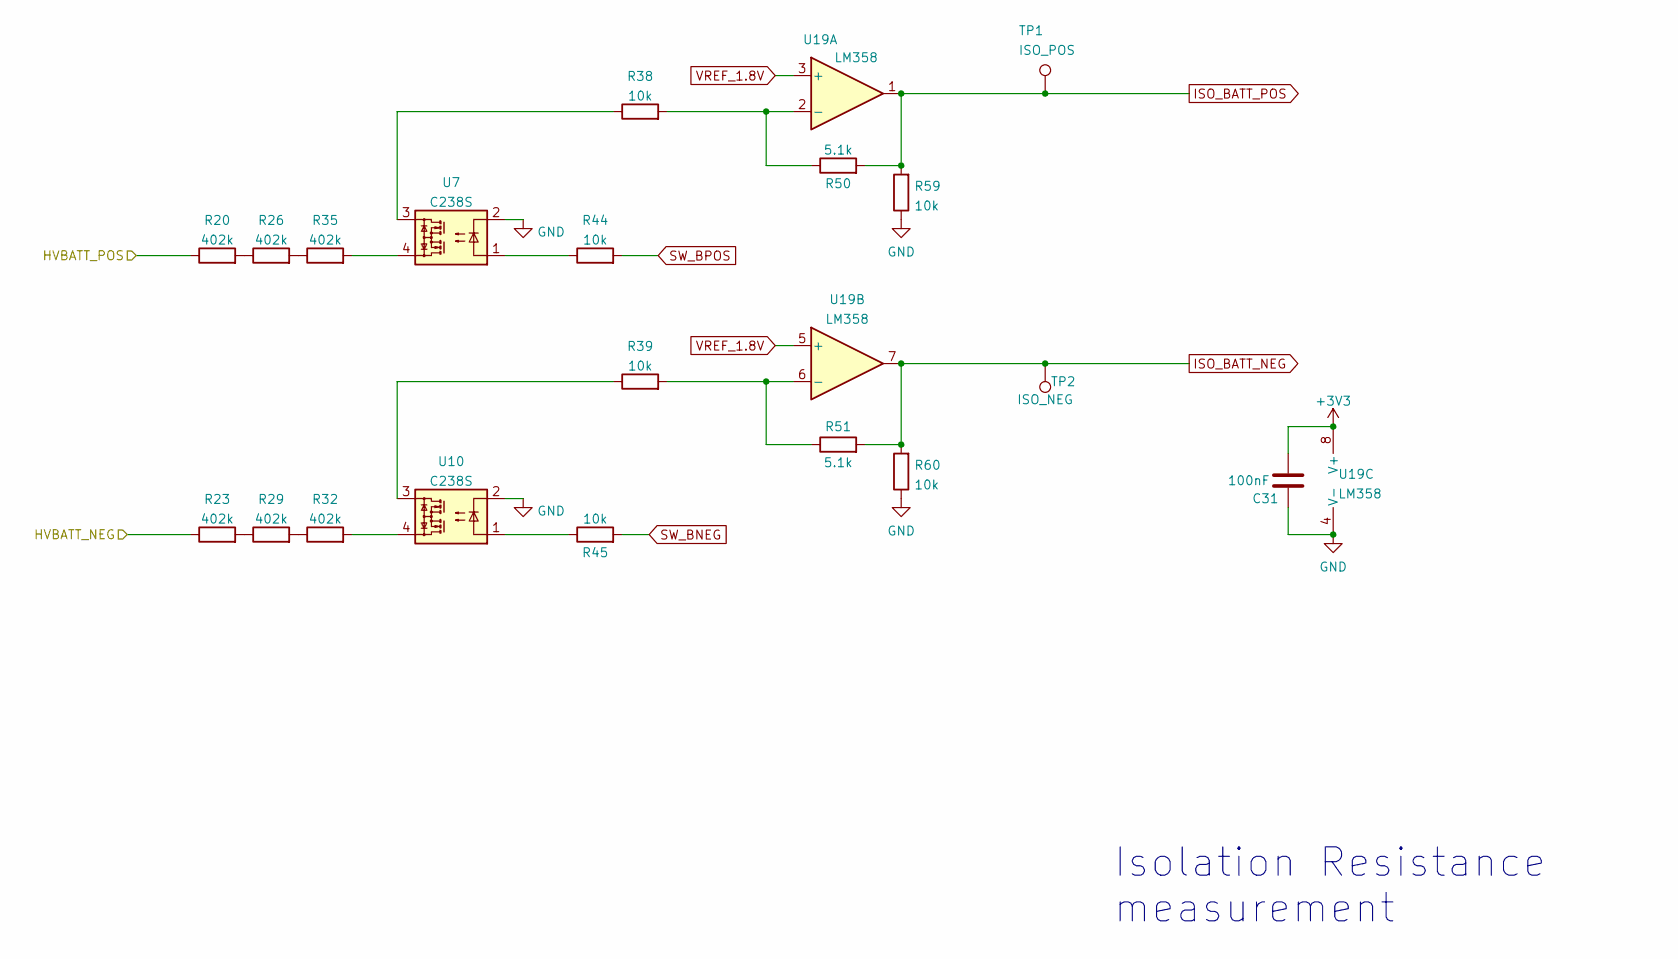
[picture p26: schematic isofault_det.kicad_sch, Tesla Model 3 Battery Controller]

Parts:
C31: 100nF; C_0603_1608Metric; LCSC Part C14663
R20, R23, R26, R29, R32, R35: 402k; R_0805_2012Metric_Pad1.20x1.40mm_HandSolder; LCSC Part C706240
R38, R39, R44, R45, R59, R60: 10k; R_0603_1608Metric; LCSC Part C25804
R50, R51: 5.1k; R_0603_1608Metric; LCSC Part C23186
TP1: ISO_POS; TestPoint_THTPad_1.5x1.5mm_Drill0.7mm
TP2: ISO_NEG; TestPoint_THTPad_1.5x1.5mm_Drill0.7mm
U7, U10: C238S; SO-4_4.4x4.3mm_P2.54mm
U19: LM358; SOIC-8_3.9x4.9mm_P1.27mm; LCSC Part C7950

Connections:
/HVBATT_NEG: R23.1; also elsewhere on the board
/HVBATT_POS: R20.1; also elsewhere on the board
GND: C31.1, R59.1, R60.1, U7.2, U10.2, U19.4 (V-); also elsewhere on the board
ISO_BATT_NEG: R51.2, R60.2, TP2.1, U19.7; also elsewhere on the board
ISO_BATT_POS: R50.2, R59.2, TP1.1, U19.1; also elsewhere on the board
unnamed: R20.2, R26.1
unnamed: R23.2, R29.1
unnamed: R26.2, R35.1
unnamed: R29.2, R32.1
unnamed: R32.2, U10.4
unnamed: R35.2, U7.4
unnamed: R38.1, U7.3
unnamed: R39.1, U10.3
unnamed: R44.1, U7.1
unnamed: R45.1, U10.1
unnamed: R38.2, R50.1, U19.2 (-)
unnamed: R39.2, R51.1, U19.6 (-)
SW_BNEG: R45.2; also elsewhere on the board
SW_BPOS: R44.2; also elsewhere on the board
VREF_1.8V: U19.3 (+), U19.5 (+); also elsewhere on the board

Notes on the sheet:
Isolation Resistance measurement

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
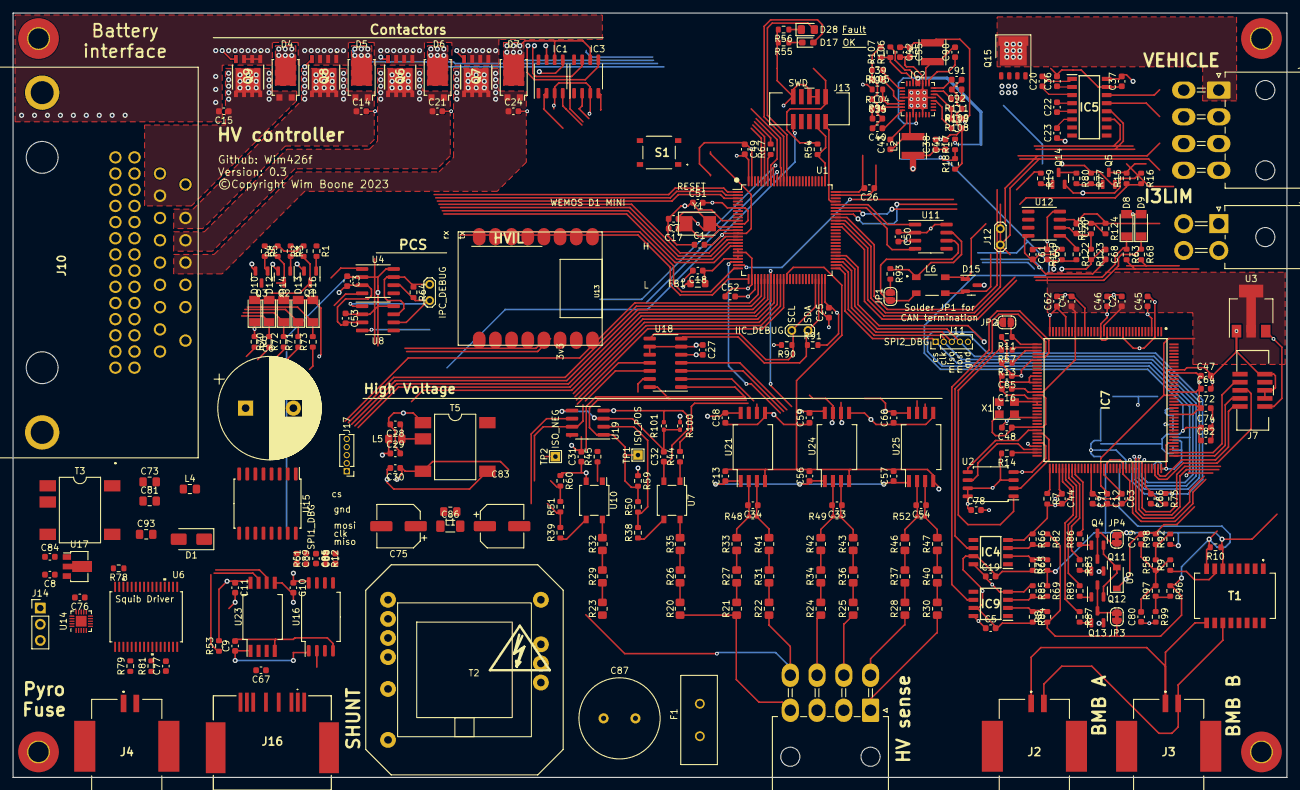
[picture p27: board hv_controller.kicad_pcb from above]

Board: 4 copper layers, 200.0 x 120.0 mm, 300 parts (1 on the bottom side), 233 nets.

Other parts of the board:
C10: 1nF; C_0603_1608Metric
