Wim426F/HVCU-Hardware/(notices)

Notices in the files:
hv_controller.kicad_pcb:
©Copyright Wim Boone 2023
parts and their libraries:
Copyright 2021 Accelerated Designs. All rights reserved.
